its-me-ivan/Capstone/FEA/11 Guage 1010 Steel Stress 100lbf.JPG

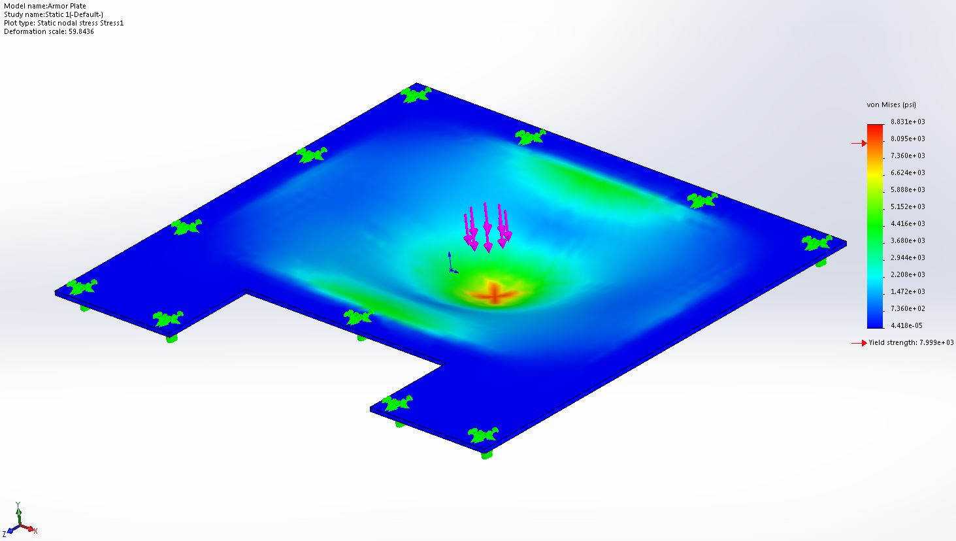
FEA/11 Guage 1010 Steel Stress 100lbf.JPG
