its-me-ivan/Capstone/FEA/3-16 Aluminum Stress 100lbf.JPG

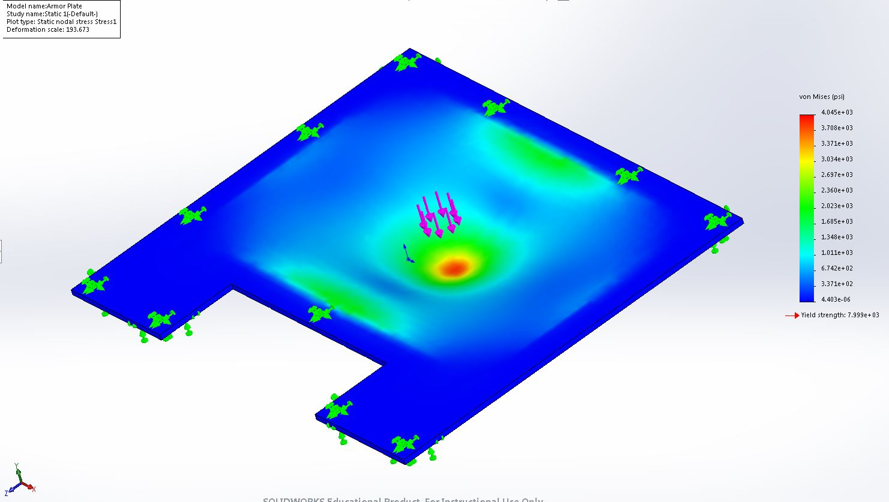
FEA/3-16 Aluminum Stress 100lbf.JPG
