its-me-ivan/Capstone/Written Report/Background.docx

# Background

From studying Battlebot competitions, a few archetypes become evident among the serious competitors. One such archetype is to have a bot with a fast spinning blade to try and shred the opponent. Another common design uses a mechanism such as a claw to try and grab the other robot and move them into obstacles. Some successful bots utilize a studded roller on the front of the bot that spins at high speed and charges the opponent to try and flip them. “Spatula” style flipping bots are also common, which slip an arm or mechanism under the opposing bot and use that to flip them. Robots that hammer the opponent with a large weapon arm often do well and can reap a lot of damage, the downfall (especially for this class of bots) is weight restriction. A heavy hammer as well as counterweight is necessary for such damage. These archetypes provide not only a starting point for deciding what our robot will do, but a point of reference for what our robot may have to face.

Consideration of different potential opponents lead to consideration of different materials to use in response to such opponents. These preliminary considerations include that for electronic housing, armor, chassis, and wheels. (Factors of each include Strength/durability/toughness vs weight/cost/machinability/allowance for heat flow away from electronic components). For example, using aluminum 6061 for parts of chassis which does not have to withstand much abuse is one initial idea. 6061 is lightweight and easily machined. It is also easily welded which will prove useful, the tradeoff is that (compared to steel or even al 7075) it is lower in strength and hardness. 7075 however is much less easily machined/ welded. Meaning that it would best used as an outer layer of armor which does not have to be welded to or interact with other components other than the chassis. Simple geometry could be used to limit the manufacturing of 7075 needed, alternatively, the utilization of a thin outer layer of UHMW polyethylene on the outside of the 6061 armor. UHMWPE has an extremely high yield point, and for a 25 pound bot, is nearly unbreakable yet is able to deform enough to dampen a heavy impact without fracture.

As for mobilization, after watching many battle bot competitions, it seems that the most common steering system is a dead axle “tank” type control system. Meaning that the left and right drivers are independent and used to steer left or right based on which motor is causing the most displacement. The turn radius and response time seems to be dictated by the distance separating inline wheels as well as distance between parallel pairs, this seems to be mostly determined through trial and error. Still under the branch of mobilization, several sizes and materials for wheels are on the market. After reading blogs published by other bot builders and by going to websites such as BaneBots.com (which manufactures quality yet affordable bot components including motors wheels gearboxes etc), it seems that Colson wheels are a good option, they are made of a durable lightweight propylene core with a thermoplastic rubber tread which will provide excellent traction on the concrete/asphalt arena. Battlebots also manufactures affordable motors available in a large variety of sizes, voltages, speeds, torques, and prices. The selected motor for this bot will also depend on the input/output voltage of the selected Arduino.

For the electronic control systems on the project, Arduino based microcontrollers are an attractive option. Many of these microcontrollers are inexpensive and Arduino is widely used by hobbyists, so resources are abundant. Arduinos also come in many shapes and sizes with different features, inputs and outputs. Keeping the electronics cheap and modular will be an important aspect to pay attention too.

Another option for the control system would be to take apart a second-hand remote-controlled vehicle and use its receiver and components. A remote-controlled plane might be a good option as they have more control surfaces and servos than a car.
