its-me-ivan/Capstone/Memos/MEMO_Week11.docx

To: James Black

Group leader: Ivan Albert for Group: Battlebots 3

CC: D2L Dropbox

Date: 11/28/18

Re: ETME/EMEC (489 or 499) Weekly Progress

# Progress

Tasks Completed:

- Finalization of solid model
- FEA of frame pieces and weapon to see their reactions under stress
- Drawing Package

Work in Progress:

- Prepare CDR materials
- Manufacturing plan
- Budget calcualtion

Upcoming Tasks and personnel assignments:

- CDR
- Compile final report

Issues and Concerns:

- Time constraints on final report
