its-me-ivan/Capstone/Memos/MEMO_Week10.docx

To: James Black

Group leader: Cole Trugman for Group: Battlebots 3

CC: D2L Dropbox

Date: 11/23/18

Re: ETME/EMEC (489 or 499) Weekly Progress

# Progress

Tasks Completed:

- Some reworking of design and solid model, using two motors instead of 4 to drive and adding a bigger weapon.
- Found electrical components for final design
- Calculations for minimum axle diameters

Work in Progress:

- Complete SolidWorks model
- Complete manufacturing plan

Upcoming Tasks and personnel assignments:

- Begin drawing package
- Prepare CDR presentation
- Make Budget plan

Issues and Concerns:

- Minimal experience with electrical systems
- Short timeframe to design solid model
- Mounting roller such that it can be removeable
- Absence of a group member
