its-me-ivan/Capstone/Memos/MEMO_Week8.docx

To: James Black

Group leader: Ivan Albert for Group: Battlebots 3

CC: D2L Dropbox

Date: 11/07/18

Re: ETME/EMEC (489 or 499) Weekly Progress

# Progress

Tasks Completed:

- Microcontroller for the Bot was chosen
- Brainstormed some ideas about the Bot model
- Came up with the basic sketch model of the Bot

Work in Progress:

- Flesh out SolidWorks model
- Update Project Management schedule

Upcoming Tasks and personnel assignments:

- Do some calculations regarding design allowable dimensions ( roller diameter, axle diameter)
- Research about motor power, and heat dissipated
- Collectively move forward with the SolidWorks model
- Make manufacturing plan
- Make Budget plan

Issues and Concerns:

- Minimal experience with electrical systems
- Short timeframe to design solid model
