its-me-ivan/Capstone/Written Report/Design Alternatives Tables.xlsx

Drive System | Maneuverability (Weight 2) | Ease of Implementation (Weight 1) | Durability (Weight 2) | Cost (Weight 1) | Total Points | Design | Drive System | Electrical System | Weapon | Armor | Total Points
Live Axel | -1 | 0 | 1 | 2 | 2 | Design 1 | Dead Axel: Wheels | Microcontroller: Bluetooth | Roller | Aluminum
Dead Axel | X | X | X | X | X |  | 9 | 8 | 9 | 4 | 30
Wheels | 1 | 2 | 2 | 1 | 9 | Design 2 | Omni Wheels | Microcontroller: Radio | Hammer | UHMWPE
Tank Treads | 1 | 1 | 0 | 0 | 3 |  | 1 | 6 | 7 | 2 | 16
Omni Wheels | 2 | -1 | -1 | 0 | 1 | Design 3 | Dead Axel: Wheels | Microcontroller: Bluetooth | Hydraulic Wedge | 1018 Steel
 |  |  |  |  |  |  | 9 | 8 | 1 | 2 | 20
Electronic Control System | Ease of Implementation (Weight 1) | Reliability of Control (Weight 1) | Versatility (Weight 2) | Cost (Weight 1) | Total Points
Off the Shelf RC Parts | 2 | 2 | -2 | 1 | 1
Microcontroller | X | X | X | X | X
Bluetooth | 1 | 1 | 2 | 2 | 8
Wi-Fi | 0 | 1 | 1 | 1 | 4
Radio | -1 | 2 | 2 | 1 | 6
Weapon System | Damage (Weight 2) | Ease of Implementation (Weight 1) | Ease of Use (Weight 2) | Cost (Weight 1) | Total Points
Hammer | 2 | 1 | 1 | 0 | 7
Roller | 2 | 1 | 2 | 0 | 9
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
