its-me-ivan/Capstone/PDR/Design Alternatives Tables PDR.xlsx

Drive System | Maneuverability | Ease of Implementation | Durability | Cost | Total Points | Design | Drive System | Electrical System | Weapon | Armor | Total Points
Live Axel | -1 | 0 | 1 | 2 | 2 | Design 1 | Dead Axle: Wheels | Micro: Bluetooth | Roller | Aluminum
Dead Axel | X | X | X | X | X |  | 6 | 5 | 5 | 3 | 19
Wheels | 1 | 2 | 2 | 1 | 6 | Design 2 | Omni Wheels | Micro: Radio | Hammer | UHMWPE
Tank Treads | 1 | 1 | 0 | 0 | 2 |  | 0 | 4 | 4 | 1 | 9
Omni Wheels | 2 | -1 | -1 | 0 | 0 | Design 3 | Dead Axle: Wheels | Micro: Bluetooth | Hydraulic Wedge | 1018 Steel
 |  |  |  |  |  |  | 6 | 5 | 0 | 2 | 13
Electronic Control System | Ease of Implementation | Reliability of Control | Versatility | Cost | Total Points
Off the Shelf RC Parts | 2 | 2 | -2 | 1 | 3
Microcontroller | X | X | X | X | X
Bluetooth | 1 | 1 | 2 | 1 | 5
Wi-Fi | 0 | 1 | 1 | 1 | 3
Radio | -1 | 2 | 2 | 1 | 4
Weapon System | Damage | Ease of Implementation | Ease of Use | Cost | Total Points
Hammer | 2 | 1 | 1 | 0 | 4
Roller | 2 | 1 | 2 | 0 | 5
Hydraulic Wedge | 0 | 0 | 1 | -1 | 0
"Hermit Crab" | 1 | 1 | -1 | 1 | 2
Spatula | 1 | 0 | 0 | -1 | 0
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
