its-me-ivan/Capstone/Memos/MEMO_Week5.docx

To: James Black

Group leader: Nishagar Raventhiran Group: Battlebots 3

CC: D2L Dropbox

Date: 10/10/18

Re: ETME/EMEC (489 or 499) Weekly Progress

# Progress

Tasks Completed:

- Chapter 4: Design Specifications
- Chapter 5: Design Alternatives

Work in Progress:

- Ideation
- Calculations to size motors/batteries for design specs

Upcoming Tasks and personnel assignments:

- Update master project management plan

Issues and Concerns:

- Minimal experience with electrical systems
