its-me-ivan/Capstone/Written Report/Problem Statement-Signed.pdf

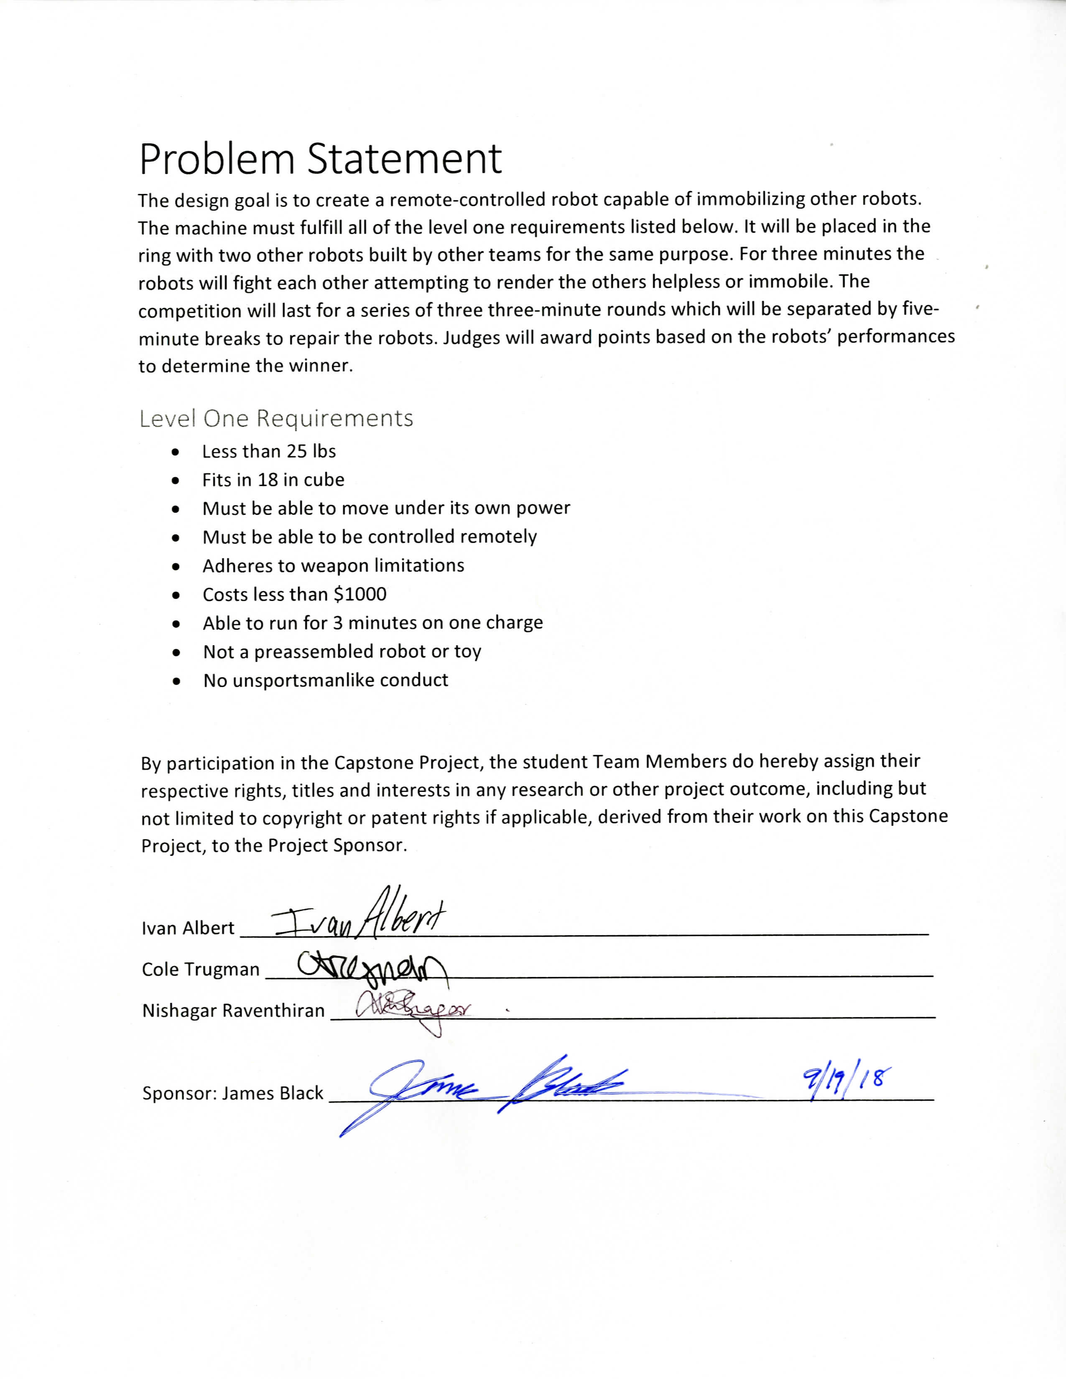
[picture p45: page 1]
