its-me-ivan/Capstone/Solidworks/Drawings/Armor Plate1.JPG

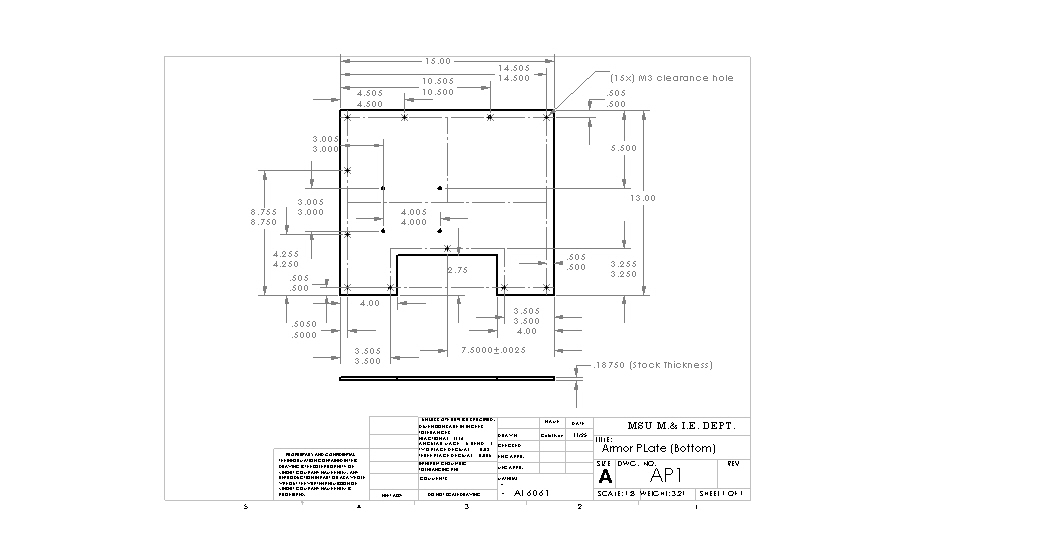
Solidworks/Drawings/Armor Plate1.JPG
