its-me-ivan/Capstone/Order Budget.xlsx

Item | Distributer | Price (Indiv) | Quantity | Price (Total)
Locally Purchased Parts
1"x2" Aluminum Rectangular Tube, 7ft | Pacific Steel & Recycling | $33.00 | 1 | $33.00 | X
1/2" Cold Rolled Steel Rod, 3ft | Pacific Steel & Recycling | $7.00 | 1 | $7.00 | X
Aluminum Flat ( Thickness)
Steel (Roller Hub)
Aluminum fo Gear box (
5/8" Hot Rolled Steel Rod, 3ft | Pacific Steel & Recycling | $6.00 | 1 | $6.00 | X
10 Guage Steel Sheet, 2"x4" | Pacific Steel & Recycling | $100.00 | 1 | $100.00
 |  | Vendor Total |  | $146.00
Ordered Parts
13A, 5-30V Single DC Motor Controller | RobotShop | $11.55 | 3 | $34.65
 |  | Shipping Cost |  | $9.00
 |  | Vendor Total |  | $43.65
6mm Bore 48 Pitch Shaft Mount Pinion Gears | ServoCity | $12.99 | 2 | $25.98
118 RPM HD Premium Planetary Gear Motor | ServoCity | $39.99 | 2 | $79.98
1621 RPM HD Premium Planetary Gear Motor | ServoCity | $39.99 | 2 | $79.98
 |  | Shipping Cost |  | $6.99
 |  | Vendor Total |  | $192.93
Tenergy NiMH 12V 4200mAh Rechargeable Battery Pack | All-Battery | $69.99 | 2 | $139.98 | X
 |  | Shipping Cost |  | $0.00
 |  | Vendor Total |  | $139.98
Colson Wheel 5in x 1-1/4in | BaneBots | $3.03 | 6 | $18.18
Colson Series 2 Hub, Press Fit, 1/2 Plain Bore, Clamp Hub | BaneBots | $4.87 | 4 | $19.48
 |  | Shipping Cost |  | $14.15
 |  | Vendor Total |  | $51.81
Raspberry Pi Zero W | Adafruit | $10.00 | 1 | $10.00 | X
 |  | Shipping Cost |  | $4.15
 |  | Vendor Total |  | $14.15
SanDisk Ultra 32GB | Amazon | $8.45 | 1 | $8.45 | X
BW® RC Servo BEC UBEC 3A 5V for Helicopter Airplane Receiver Servo Power Supply | Amazon | $7.99 | 1 | $7.99 | X
 |  | Shipping Cost |  | $0.00
 |  | Vendor Total |  | $16.44
1375k450 - MXL Series Timing Belt Pulley | McMaster-Carr | $11.73 | 1 | $11.73
1375k560 - MXL Series Timing Belt Pulley | McMaster-Carr | $15.89 | 4 | $63.56
1254N21 - MXL Series Lightweight Timing Belt Pulley | McMaster-Carr | $7.46 | 1 | $7.46
1434k600 - Mounted Roller Bearing with Two-Bolt Flange | McMaster-Carr | $17.67 | 4 | $70.68
6832k44 - Metal Gear - 20 Degree Pressure Angle | McMaster-Carr | $21.55 | 2 | $43.10
6383k213 - Ball Bearing | McMaster-Carr | $3.97 | 2 | $7.94
92871A013 - 18-8 Stainless Steel Unthreaded Spacer | McMaster-Carr | $1.72 | 12 | $20.64
7887K88 - MXL Series Timing Belt | McMaster-Carr | $5.66 | 2 | $11.32
7887K82 - MXL Series Timing Belt | McMaster-Carr | $2.85 | 1 | $2.85 | 4.24 center
92095A182 - Button Head Hex Drive Screw - 100 pack | McMaster-Carr | $8.38 | 1 | $8.38
92095A203 - Button Head Hex Drive Screw - 25 pack | McMaster-Carr | $4.28 | 1 | $4.28
99437A135 - Zinc-Plated Steel Press-Fit Nut for Sheet Metal - 10 pack | McMaster-Carr | $6.13 | 2 | $12.26
 |  | Shipping Cost |  | Unknown
 |  | Vendor Total |  | $264.20
 |  | Total Cost |  | $869.16
 |  | Total Budget |  | $1000.00
 |  | Remaining Budget |  | $130.84
Bolts /screws
Armor (Screw) | 18 x >.5" | 4>.625"
Gearboxes (Bolt/Nut) | 8 x 1.5"
Motors | 12 x
Electronic Mount
Bearings (Bolt/Nut) | 8 x .5"
Roller mount | 2 x >.25"
