its-me-ivan/Capstone/Written Report/Part List.xlsx

Sheet: Purchased Parts
Part Number | Description | Manufacturer/Vendor | Vendor Part Number | Quantity
P1 | MXL series timing belt pulley, 24 teeth, 1/4 in shaft diameter | McMaster-Carr | 1375k450 | 2
P2 | MXL series timing belt pulley, 42 teeth, 1/4 in shaft diameter | McMaster-Carr | 1375k560 | 4
P3 | Mounted roller bearing with two-bolt flange for 1/2" shaft diamteter | McMaster-Carr | 1434k600 | 4
P4 | Metal gear, 48 pitch, 36 teeth, round bore with set screw for 1/4" shaft diameter | McMaster-Carr | 6832k44 | 2
P5 | Flanged ball bearing for 1/4" shaft | McMaster-Carr | 6383k213 | 2
P6 | 118 RPM HD Premium Planetary Gear Motor | ServoCity | 118 RPM HD Premium Planetary Gear Motor | 2
P7 | 1621 RPM HD Premium Planetary Gear Motor | ServoCity | 1621 RPM HD Premium Planetary Gear Motor | 1
P8 | Tenergy NiMH 12V 4200mAh Rechargeable Battery Pack | All-Battery | 11600 | 2
P9 | RC Servo BEC UBEC 3A 5V for Helicopter Airplane Receiver Servo Power Supply | BW/Amazon | RC Servo BEC UBEC 3A 5V for Helicopter Airplane Receiver Servo Power Supply | 1
P10 | 13A, 5-30V Single DC Motor Controller | Cytron/RobotShop | RB-Cyt-132 | 3
P11 | Raspberry Pi Zero W | Raspberry Pi Foundation/Adafruit | 3400 | 2
P12 | 18-8 SS 10mm long M3 spacer | McMaster-Carr | 92871A013 | 12
P13
P14
P15
P16
P17
P18
P19
P20
P21
P22
P23
P24
P25

Sheet: Raw Materials
Material Number | Description | Manufacturer/Vendor | Quantity
R1 | 10 ft 1"x2"x1/8" 6063-T52 Aluminum Rectangular Tube | Midwest Steel and Aluminum | 1
R2 | 3/16" 6061 Aluminum Plate 2'x3' | The Metal Store | 1
R3 | 4"x5"x0.25 foam | scrap | 1
R4 | PLA Fillament | MSU Makerspace | 4 parts
R5 | 2"x2"x1' 6061 Aluminum Square Bar | Metals Depot | 1
R6 | 1/2" 1018 Cold Finish Steel Round 4ft length | Metals Depot | 1
R7 | 5/8" 1018 Cold Finish Steel Round 2ft length | Metals Depot | 1
R8 | 3/8"x4"x2' A-36 Steel Flat | Metals Depot | 1
R9
R10
R11
R12
R13
