its-me-ivan/Capstone/Budget Plan (version 1).xlsx

Parts | Quantity | price of each | Total cost | Total budget
165 RPM HD Premium Planetary Gear Motor | 2 | $39.99 | $79.98 | $822.58
Cytron 13A, 5-30V Single DC Motor Controller | 4 | $13.82 | $55.28
Raspberry Pi Zero W | 2 | $10.00 | $20.00
Tenergy NiMH 12V 4200mAh Rechargeable Battery Pack | 2 | $69.99 | $139.98
1,621 RPM HD Premium Planetary Gear Motor | 1 | $39.99 | $39.99
RC Servo BEC UBEC 3A 5V ( Receiver servo Power supply) | 1 | $7.99 | $7.99
6063-T52 Aluminum Rectangle Tube(2X1X1/8 Wall) | 1 | $32.15 | $32.15
3/16 inch. thick 6061 Aluminum Plate (2 ftX3 ft) | 1 | $109.47 | $109.47
5/8" Hot Rolled A-36 Steel Round | 1 | $5.14 | $5.14
1/2" Hot Rolled A-36 Steel Round | 1 | $6.60 | $6.60
Bearing | 4 | $11.00 | $44.00
Roller Bearing | 2 | $10 | $20.00
Pulley | 4 | $16.00 | $64.00
Driving Belt | 2 | $6.00 | $12.00
Gears | 2 | $22.00 | $44.00
Gears | 2 | $13.00 | $26.00
5" wheels/hubs | 6 | $16.00 | $96.00
Screws | 1 | $20.00 | $20.00
