its-me-ivan/Capstone/Budget Plan.xlsx

Parts | Quantity | price of each | Total cost | Total budget
165 RPM HD Premium Planetary Gear Motor | 2 | $39.99 | $79.98 | $382.60
Cytron 13A, 5-30V Single DC Motor Controller | 3 | $13.82 | $41.46
Raspberry Pi Zero W | 1 | $10.00 | $10.00
Tenergy NiMH 12V 4200mAh Rechargeable Battery Pack | 2 | $69.99 | $139.98
1,621 RPM HD Premium Planetary Gear Motor | 1 | $39.99 | $39.99
6063-T52 Aluminum Rectangle Tube(2X1X1) | 1 | $3.49 | $3.49
6061-T6511 Aluminum Flat(31/16 X 6X 18) | 1 | $61.70 | $61.70
Hot Rolled A-36 Steel Round 30 in | 1 | $6.00 | $6.00
Bearings
