its-me-ivan/Capstone/Solidworks/Subassemblies/Robot 2.SLDASM

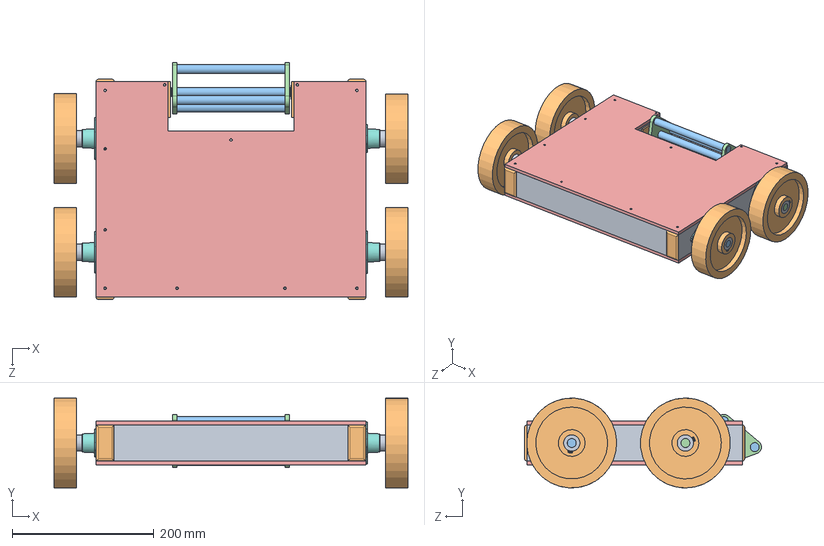
[picture p47: CAD file, 2019-02-06]
Solidworks/Subassemblies/Robot 2.SLDASM
500.0 x 127.0 x 334.7 mm
Box Frame x 8
Tube Cap x 4
Roller 2 Bar x 4
Roller Bracket x 2
Armor Plate x 2
Gearbox x 2
Motor x 3
Pinion Gear x 2
Motor Mount
Electronic Mounting Plate Foam
Electronic Mounting Plate
Motor Control Board x 3
Raspberry Pi
92871A013_SS UNTHRD SPACER x 8
Drivin GEAR--20 DEG PRESSURE ANGLE x 2
1434K600_LIGHT DTY TWO-BOLT FLANGE-MOUNTED ROLLER BRNG x 4
Wheel Hub x 4
Wheel x 4
Axle Cole x 2
Axle2 Cole x 2
Battery Pack
1375K560_MXL SERIES TIMING BELT PULLEY(.5) x 4
Roller Motor MXL SERIES LIGHTWEIGHT TIMING BELT PULLEY
(Roller) 6383K213_BALL BEARING x 2
(Roller)1375K450_MXL SERIES TIMING BELT PULLEY
Roller Attachment 2 x 2
