its-me-ivan/Capstone/Solidworks/Subassemblies/Frame 2.SLDASM

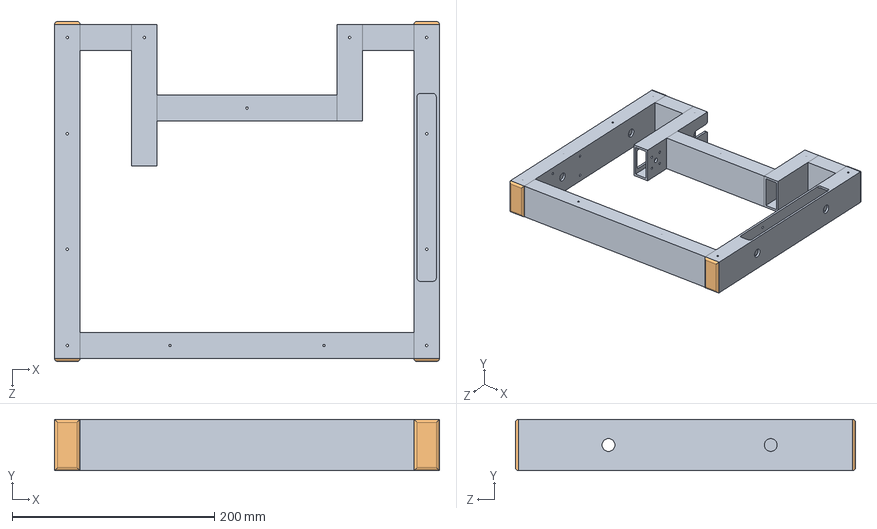
[picture p48: CAD file, 2019-02-05]
Solidworks/Subassemblies/Frame 2.SLDASM
381.0 x 50.8 x 336.5 mm
Box Frame x 8
Tube Cap x 4
