its-me-ivan/Capstone/Solidworks/Subassemblies/Gearbox.SLDASM

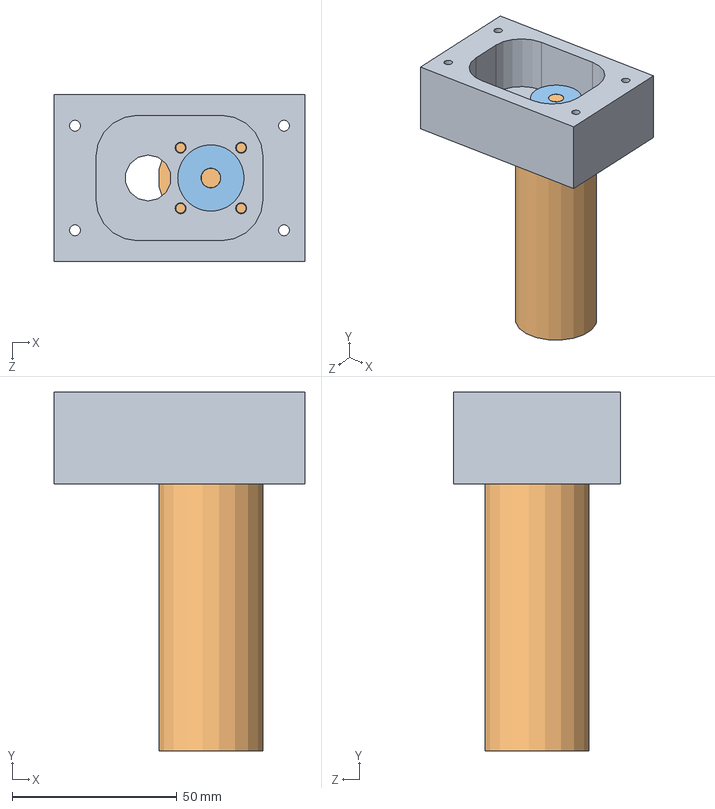
[picture p49: CAD file, 2019-02-05]
Solidworks/Subassemblies/Gearbox.SLDASM
76.2 x 109.0 x 50.8 mm
Gearbox
Motor
Pinion Gear
