its-me-ivan/Capstone/Solidworks/Subassemblies/Roller 2.SLDASM

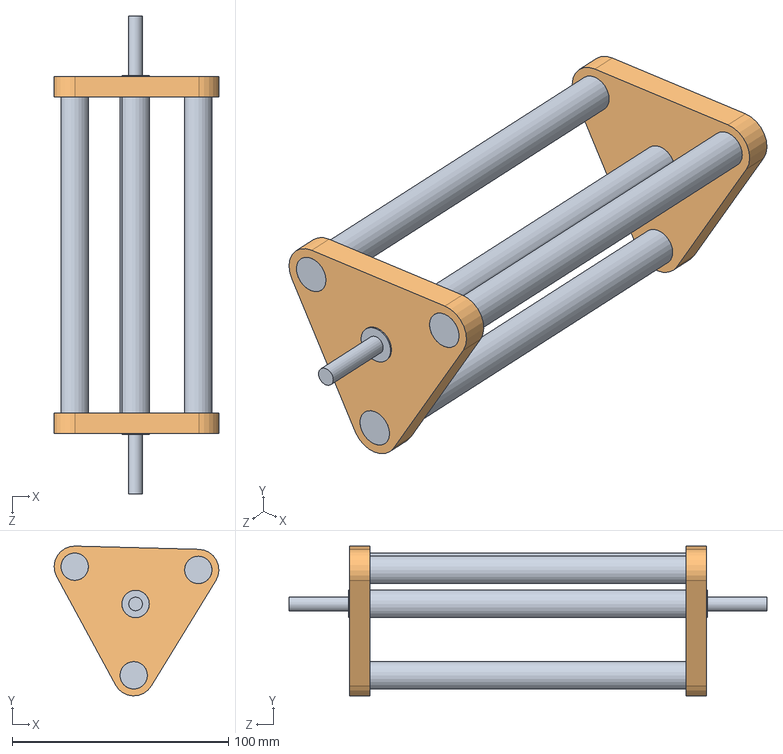
[picture p50: CAD file, 2019-02-05]
Solidworks/Subassemblies/Roller 2.SLDASM
76.2 x 69.3 x 221.0 mm
Roller 2 Bar x 4
Roller Bracket x 2
