its-me-ivan/Capstone/Solidworks/Subassemblies/Electrical Mounting.SLDASM

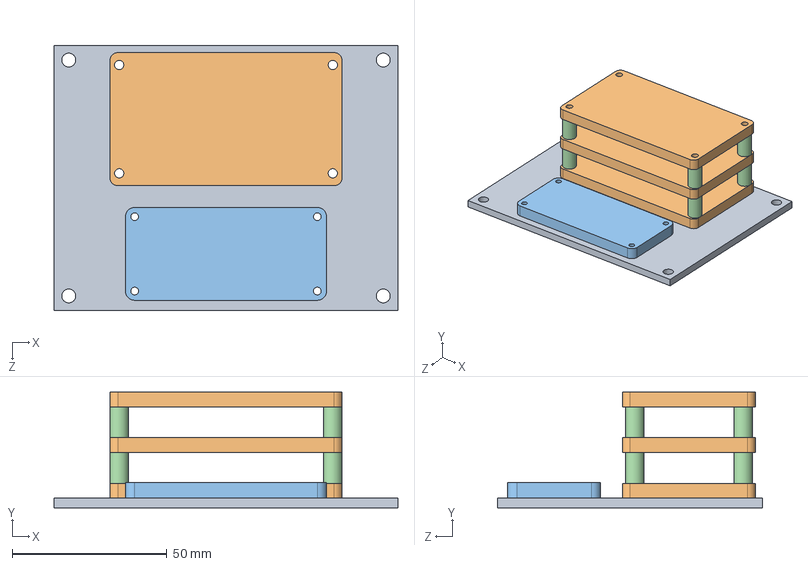
[picture p51: CAD file, 2018-11-29]
Solidworks/Subassemblies/Electrical Mounting.SLDASM
111.1 x 37.5 x 85.7 mm
Electronic Mounting Plate
Motor Control Board x 3
Raspberry Pi
92871A013_SS UNTHRD SPACER x 8
