its-me-ivan/Capstone/Solidworks/Subassemblies/Roller.SLDASM

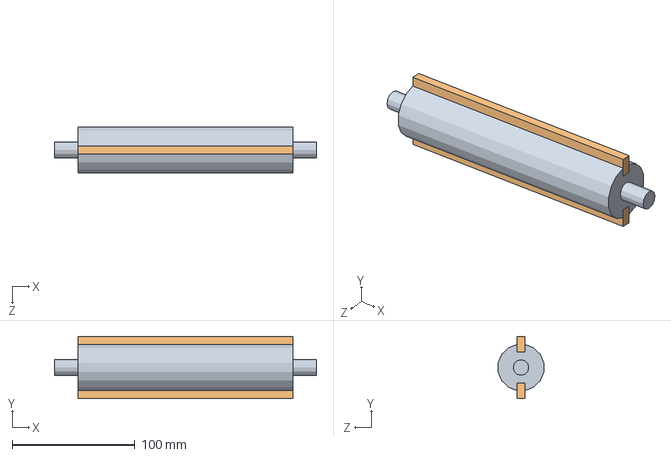
[picture p52: CAD file, 2018-11-13]
Solidworks/Subassemblies/Roller.SLDASM
213.4 x 50.8 x 37.3 mm
Roller
Roller Tooth x 2
