its-me-ivan/Capstone/Solidworks/Subassemblies/Frame.SLDASM

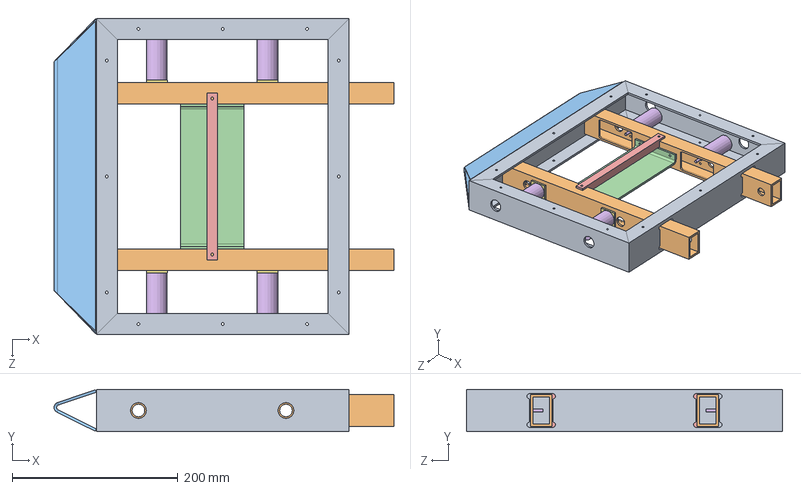
[picture p53: CAD file, 2018-11-13]
Solidworks/Subassemblies/Frame.SLDASM
409.7 x 50.8 x 381.0 mm
Frame C-Channel x 4
Roller Arm x 2
Rear Bumper
Electronics Tray
Cross Brace x 2
Motor x 4
Motor Mount x 4
