its-me-ivan/Capstone/Solidworks/Subassemblies/Robot.SLDASM

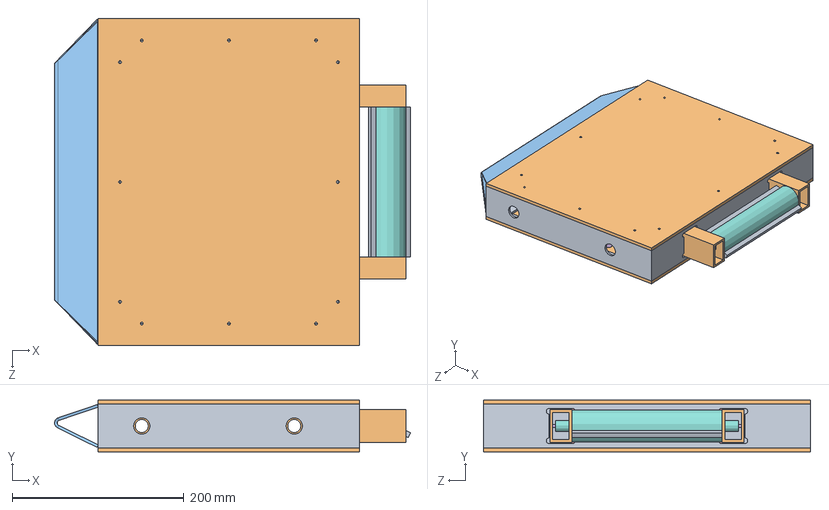
[picture p54: CAD file, 2018-11-13]
Solidworks/Subassemblies/Robot.SLDASM
415.0 x 60.3 x 381.0 mm
Frame C-Channel x 4
Roller Arm x 2
Rear Bumper
Electronics Tray
Cross Brace x 2
Motor x 5
Motor Mount x 5
Roller
Roller Tooth x 2
Armor Plate x 2
Raspberry Pi
