its-me-ivan/Capstone/Solidworks/Electronics/Electronic Mounting Plate.SLDPRT

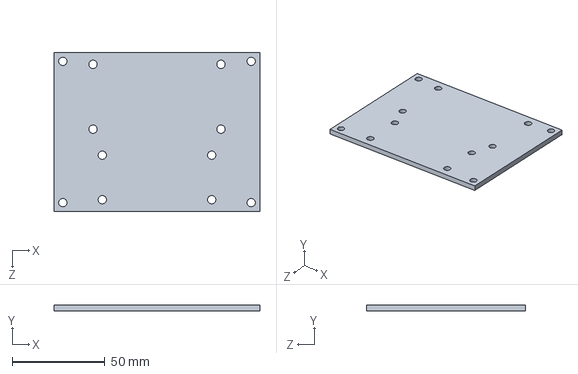
[picture p55: CAD file, 2018-11-29]
Solidworks/Electronics/Electronic Mounting Plate.SLDPRT
111.1 x 3.17 x 85.7 mm
