its-me-ivan/Capstone/Solidworks/Hardware/Wheel Hub.SLDPRT

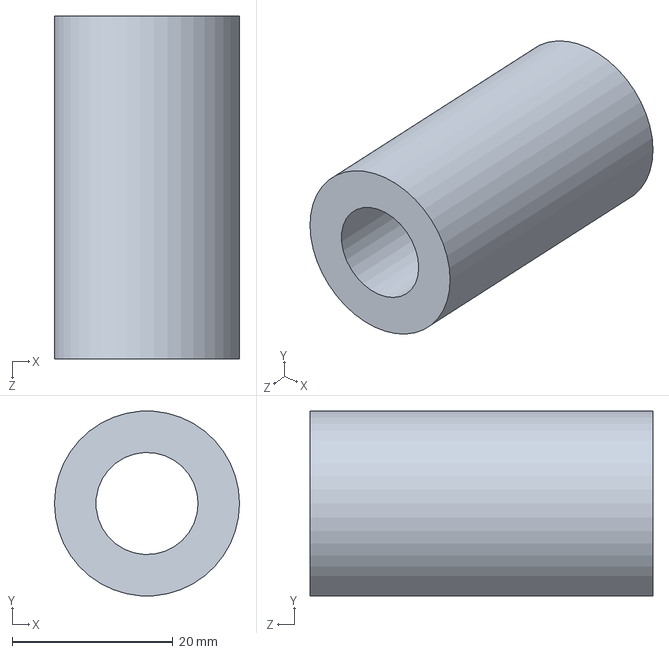
[picture p56: CAD file, 2019-02-06]
Solidworks/Hardware/Wheel Hub.SLDPRT
23.0 x 23.0 x 42.7 mm
