its-me-ivan/Capstone/Solidworks/Machined Parts/Armor Plate.SLDPRT

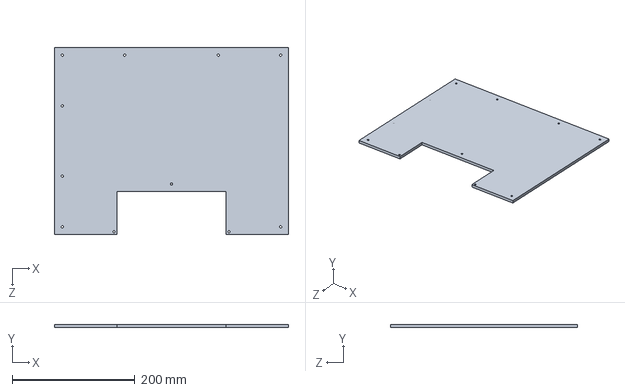
[picture p57: CAD file, 2019-02-06]
Solidworks/Machined Parts/Armor Plate.SLDPRT
381.0 x 5.59 x 304.8 mm
