its-me-ivan/Capstone/Solidworks/Electronics/Motor.SLDPRT

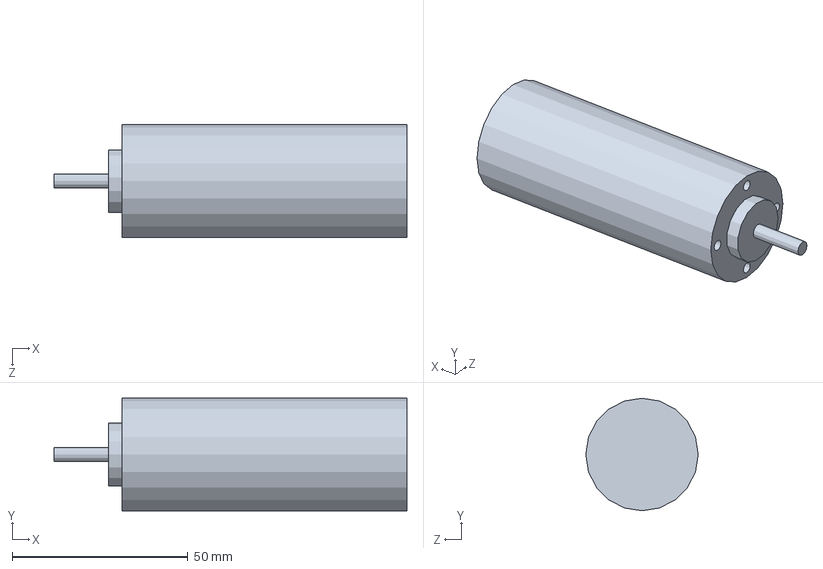
[picture p58: CAD file, 2018-11-26]
Solidworks/Electronics/Motor.SLDPRT
100.4 x 32.0 x 32.0 mm
