its-me-ivan/Capstone/Solidworks/Hardware/Wheel.SLDPRT

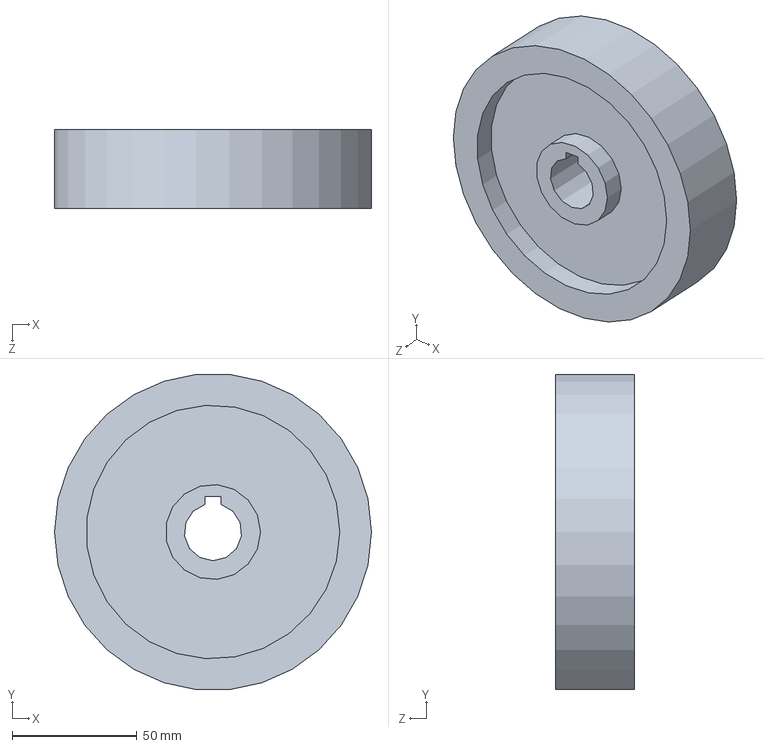
[picture p59: CAD file, 2019-02-06]
Solidworks/Hardware/Wheel.SLDPRT
127.0 x 126.3 x 31.8 mm
