its-me-ivan/Capstone/Solidworks/Machined Parts/Box Frame.SLDPRT

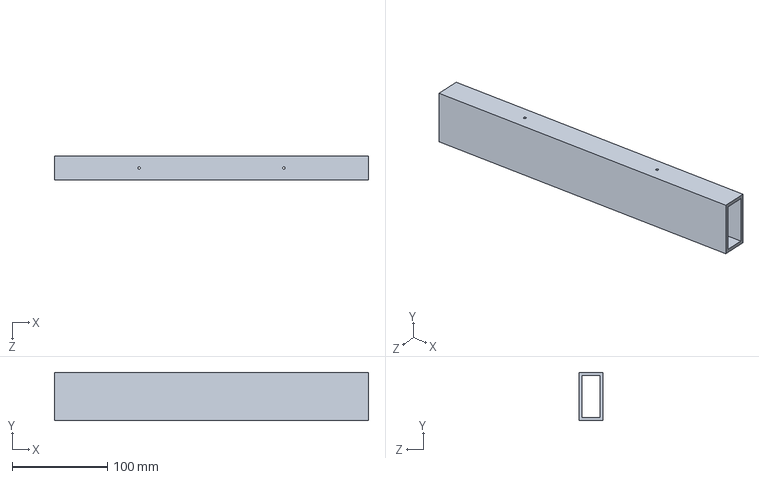
[picture p60: CAD file, 2019-02-05]
Solidworks/Machined Parts/Box Frame.SLDPRT
330.2 x 50.8 x 25.4 mm
