its-me-ivan/Capstone/Solidworks/Electronics/Raspberry Pi.SLDPRT

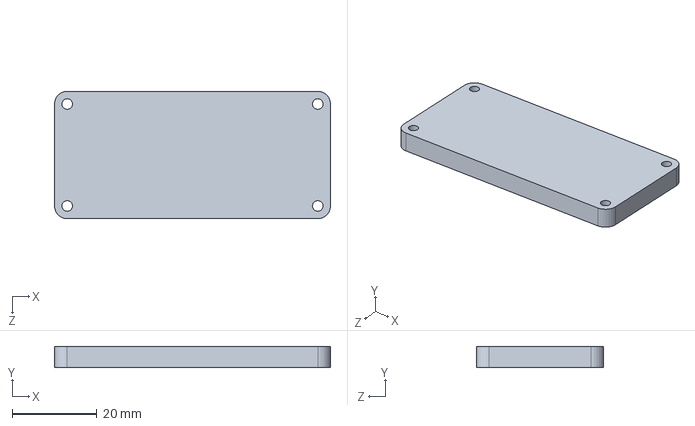
[picture p61: CAD file, 2018-11-24]
Solidworks/Electronics/Raspberry Pi.SLDPRT
65.0 x 5.00 x 30.0 mm
