its-me-ivan/Capstone/Solidworks/Hardware/Pinion Gear.SLDPRT

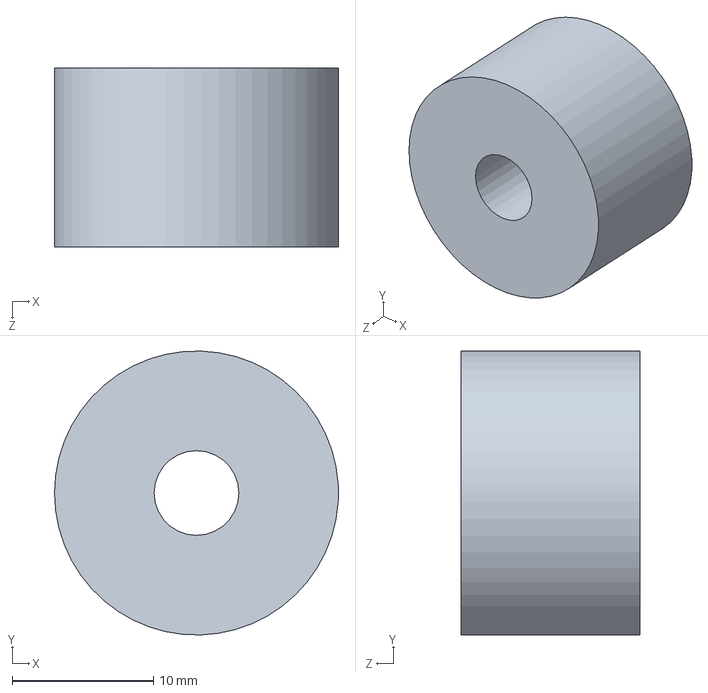
[picture p62: CAD file, 2018-11-24]
Solidworks/Hardware/Pinion Gear.SLDPRT
20.1 x 20.1 x 12.7 mm
