its-me-ivan/Capstone/Solidworks/Machined Parts/Gearbox.SLDPRT

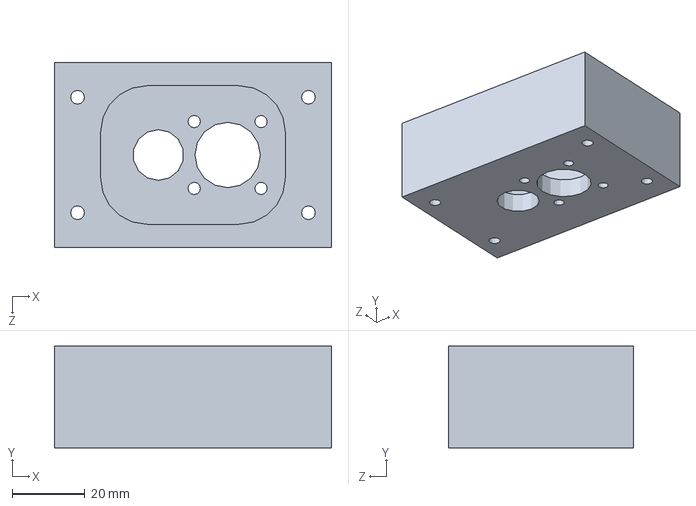
[picture p63: CAD file, 2019-02-05]
Solidworks/Machined Parts/Gearbox.SLDPRT
76.2 x 27.9 x 50.8 mm
