its-me-ivan/Capstone/Solidworks/Electronics/Motor Control Board.SLDPRT

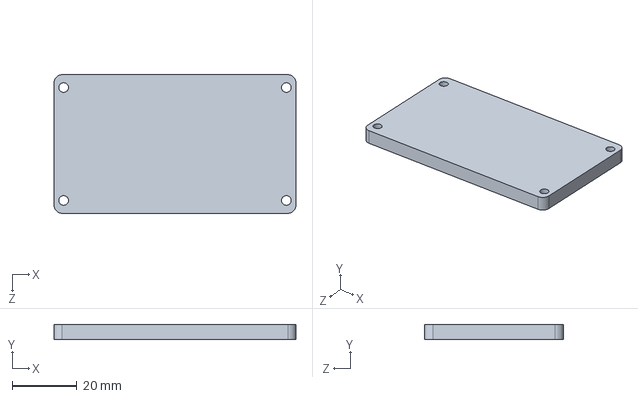
[picture p64: CAD file, 2018-11-24]
Solidworks/Electronics/Motor Control Board.SLDPRT
75.0 x 4.76 x 43.0 mm
