its-me-ivan/Capstone/Solidworks/Hardware/Axle.SLDPRT

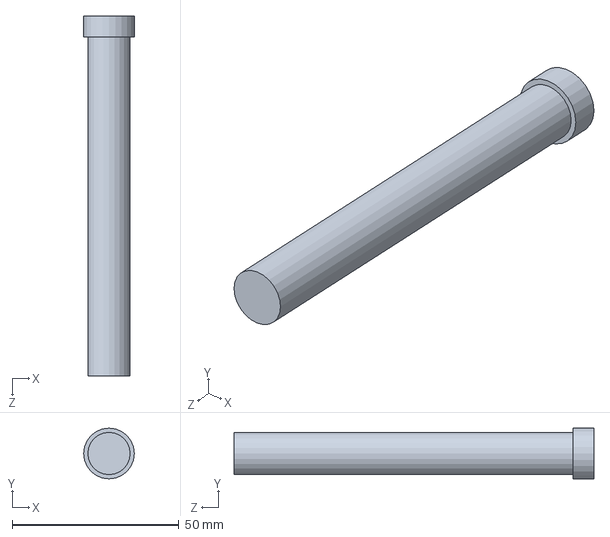
[picture p65: CAD file, 2018-11-22]
Solidworks/Hardware/Axle.SLDPRT
15.2 x 15.2 x 108.0 mm
