its-me-ivan/Capstone/Solidworks/Machined Parts/Roller Attachment 2.SLDPRT

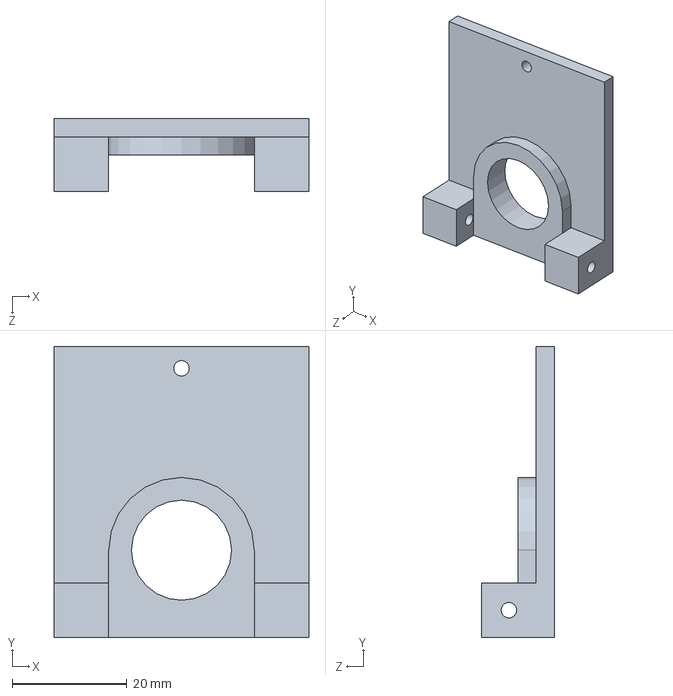
[picture p66: CAD file, 2019-02-05]
Solidworks/Machined Parts/Roller Attachment 2.SLDPRT
44.5 x 50.8 x 12.7 mm
