its-me-ivan/Capstone/Solidworks/Electronics/Electronic Mounting Plate Foam.SLDPRT

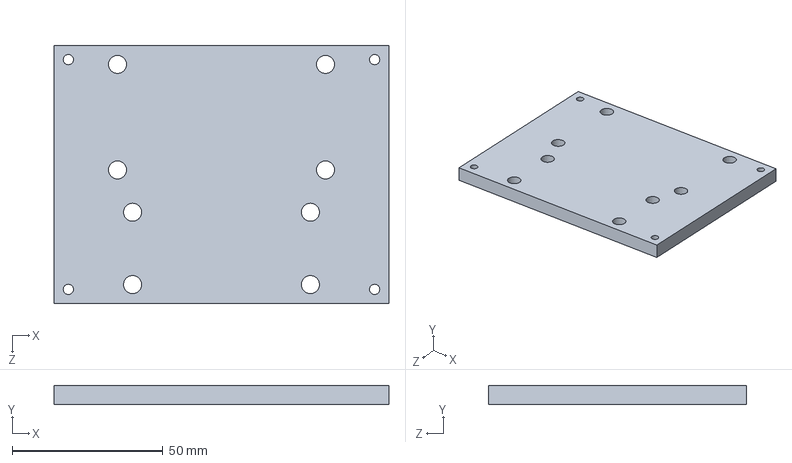
[picture p67: CAD file, 2018-11-24]
Solidworks/Electronics/Electronic Mounting Plate Foam.SLDPRT
111.1 x 6.35 x 85.7 mm
