its-me-ivan/Capstone/Solidworks/Machined Parts/Roller Bracket.SLDPRT

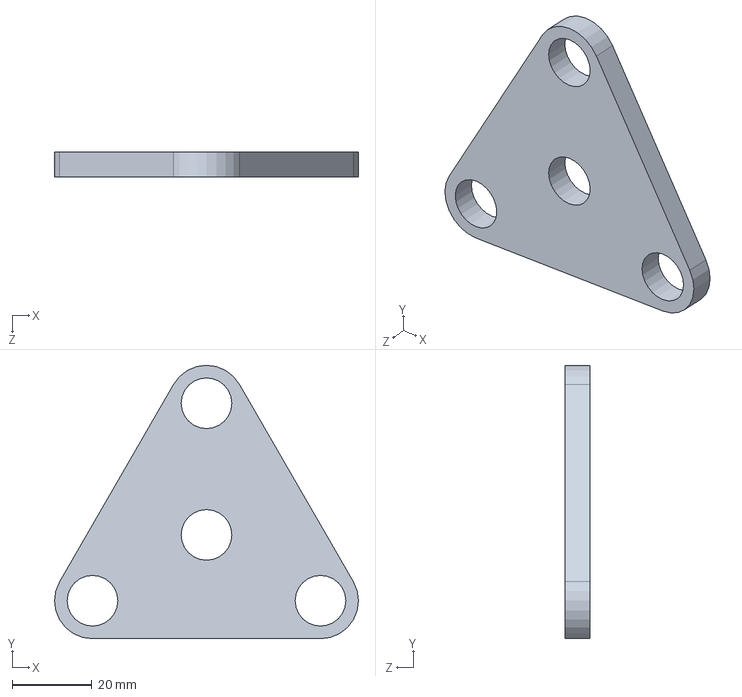
[picture p68: CAD file, 2019-02-05]
Solidworks/Machined Parts/Roller Bracket.SLDPRT
76.2 x 68.5 x 6.35 mm
