its-me-ivan/Capstone/Solidworks/Electronics/Battery Pack.SLDPRT

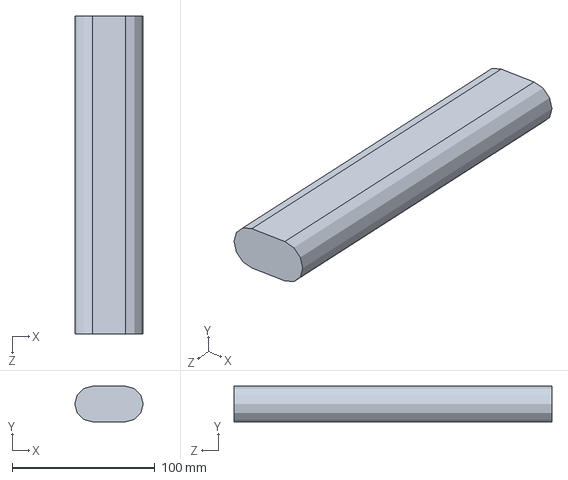
[picture p69: CAD file, 2018-11-24]
Solidworks/Electronics/Battery Pack.SLDPRT
48.0 x 25.0 x 223.0 mm
