its-me-ivan/Capstone/Solidworks/Machined Parts/Roller 2 Bar.SLDPRT

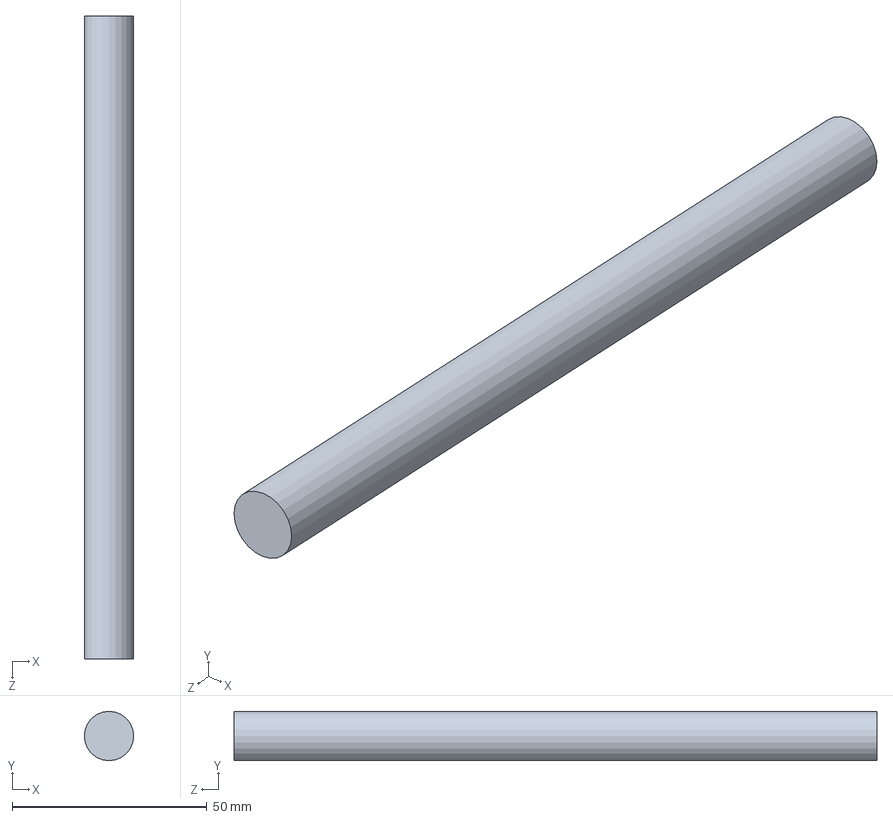
[picture p70: CAD file, 2019-01-17]
Solidworks/Machined Parts/Roller 2 Bar.SLDPRT
12.7 x 12.7 x 165.1 mm
