its-me-ivan/Capstone/Solidworks/Electronics/Motor2.SLDPRT

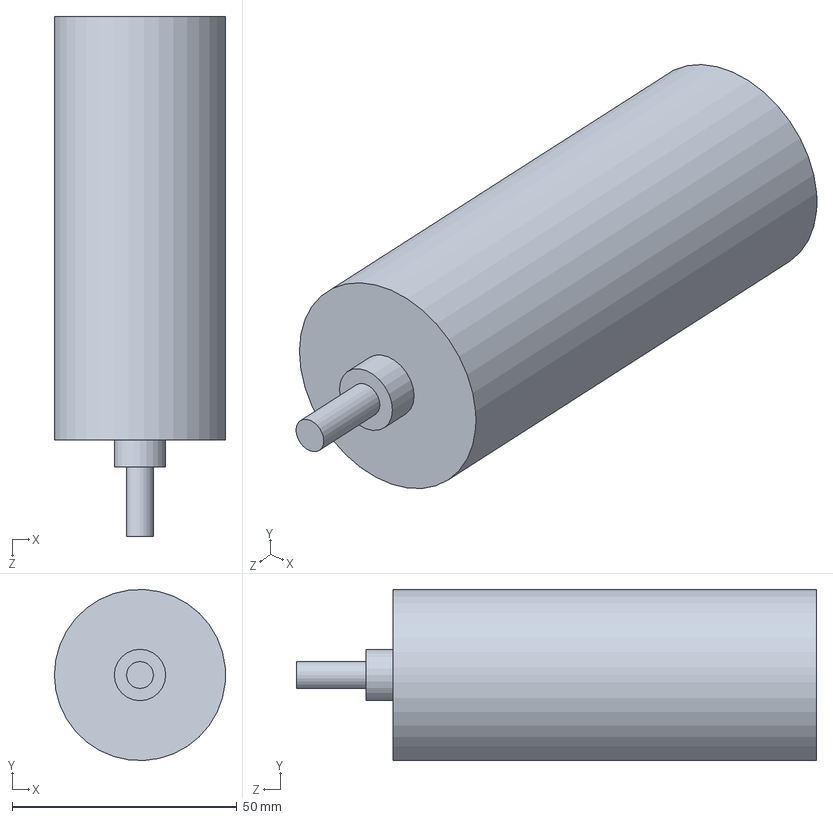
[picture p71: CAD file, 2018-11-23]
Solidworks/Electronics/Motor2.SLDPRT
38.1 x 38.1 x 115.7 mm
