its-me-ivan/Capstone/Solidworks/Machined Parts/Roller Brackets.SLDPRT

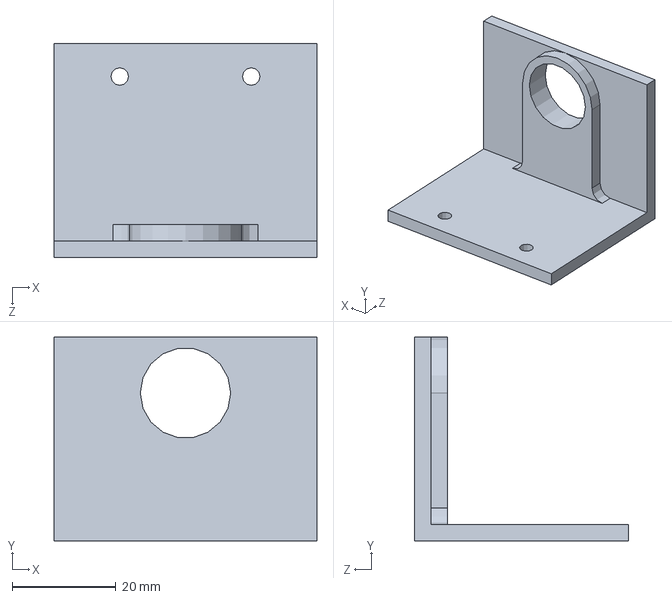
[picture p72: CAD file, 2019-01-17]
Solidworks/Machined Parts/Roller Brackets.SLDPRT
50.8 x 39.4 x 41.3 mm
