its-me-ivan/Capstone/Solidworks/Machined Parts/Tube Cap.SLDPRT

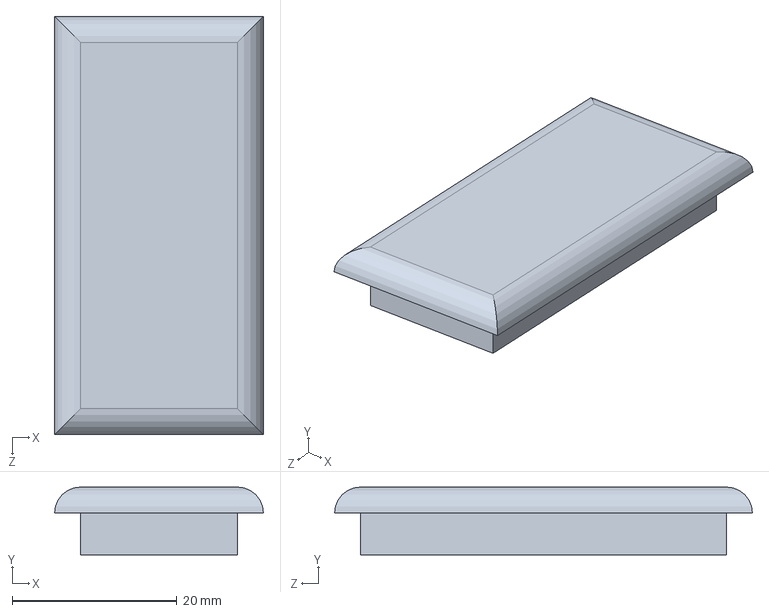
[picture p73: CAD file, 2018-12-06]
Solidworks/Machined Parts/Tube Cap.SLDPRT
25.4 x 8.26 x 50.8 mm
