its-me-ivan/Capstone/Solidworks/Machined Parts/Axle2 Cole.SLDPRT

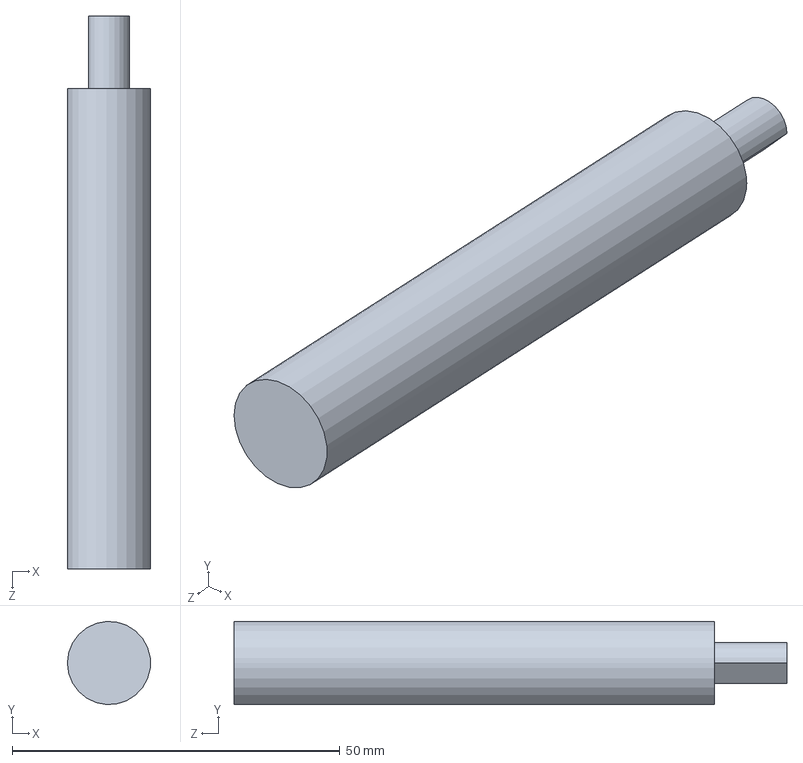
[picture p74: CAD file, 2018-11-27]
Solidworks/Machined Parts/Axle2 Cole.SLDPRT
12.7 x 12.7 x 84.4 mm
