its-me-ivan/Capstone/Solidworks/Machined Parts/Axle Cole.SLDPRT

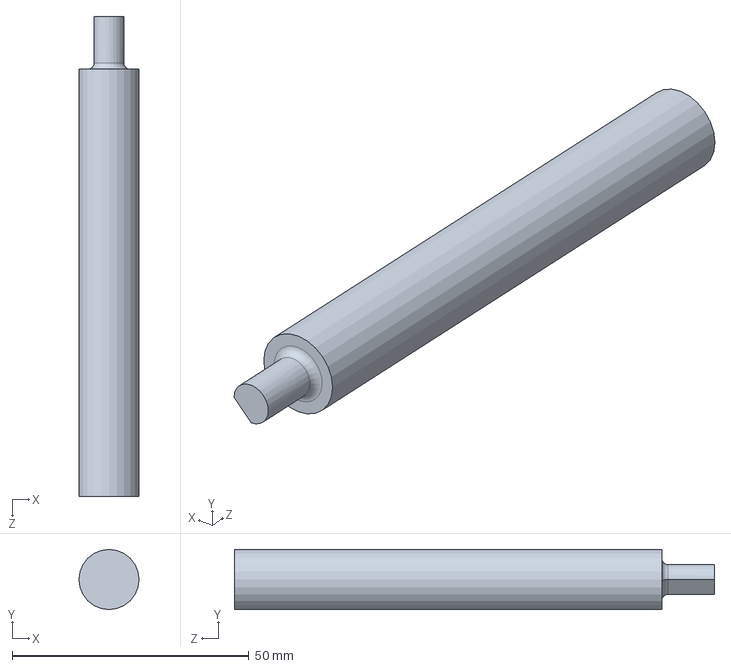
[picture p75: CAD file, 2018-11-24]
Solidworks/Machined Parts/Axle Cole.SLDPRT
12.7 x 12.7 x 101.4 mm
