its-me-ivan/Capstone/Solidworks/Machined Parts/Axle.SLDPRT

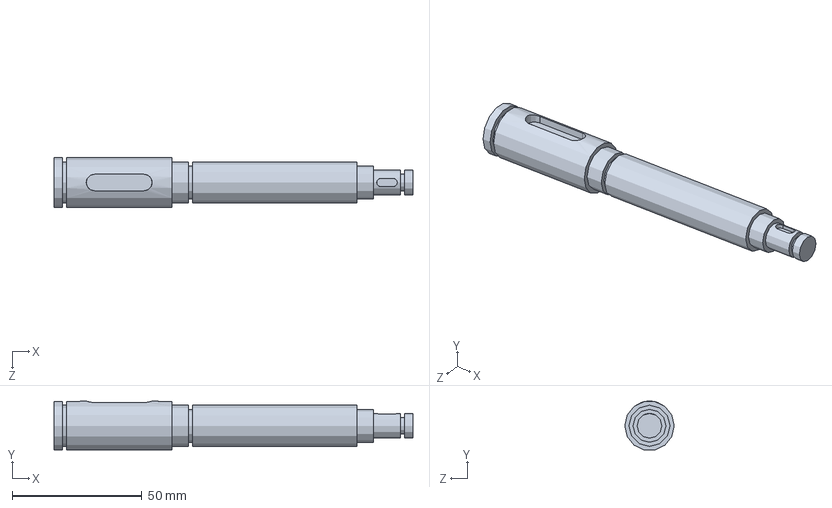
[picture p76: CAD file, 2018-11-24]
Solidworks/Machined Parts/Axle.SLDPRT
138.1 x 18.8 x 19.1 mm
