its-me-ivan/Capstone/Solidworks/Machined Parts/Motor Mount.SLDPRT

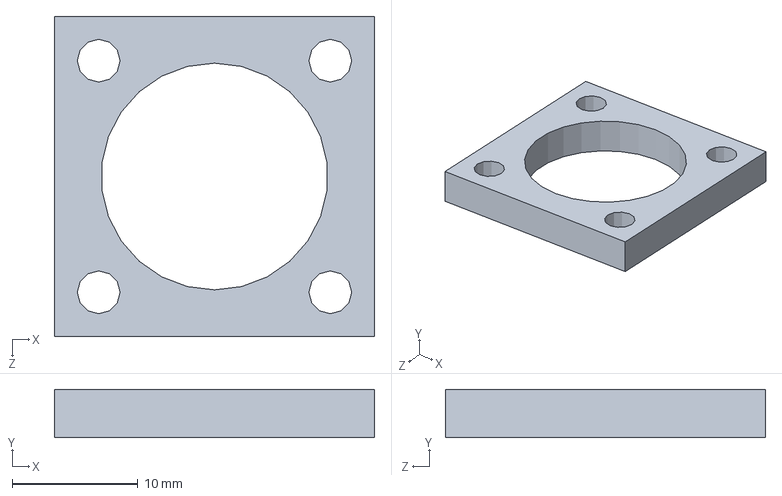
[picture p77: CAD file, 2018-11-24]
Solidworks/Machined Parts/Motor Mount.SLDPRT
25.4 x 3.81 x 25.4 mm
