its-me-ivan/Capstone/Solidworks/Machined Parts/Roller Arm.SLDPRT

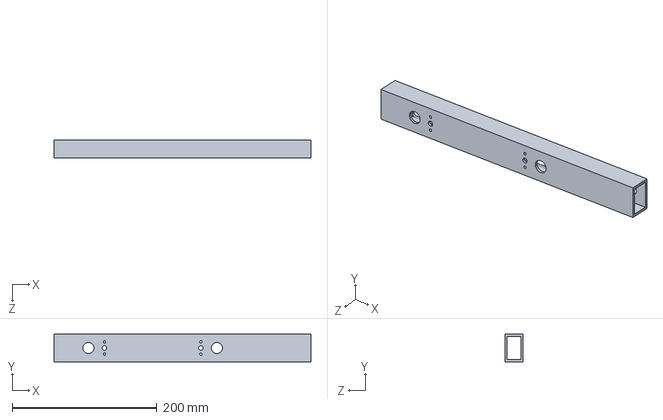
[picture p78: CAD file, 2018-11-13]
Solidworks/Machined Parts/Roller Arm.SLDPRT
355.6 x 38.1 x 25.4 mm
