its-me-ivan/Capstone/Solidworks/Machined Parts/Roller.SLDPRT

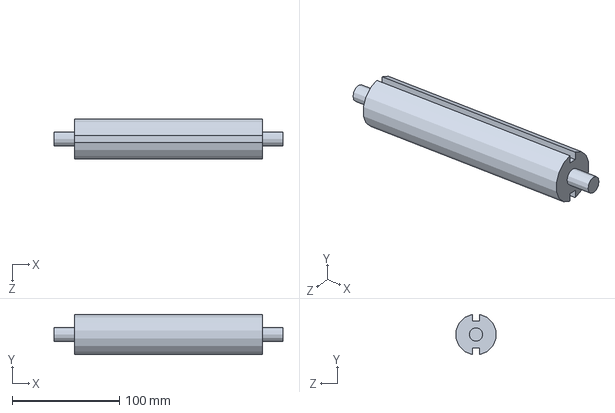
[picture p79: CAD file, 2018-11-13]
Solidworks/Machined Parts/Roller.SLDPRT
213.4 x 37.6 x 37.3 mm
