its-me-ivan/Capstone/Solidworks/Machined Parts/Frame C-Channel.SLDPRT

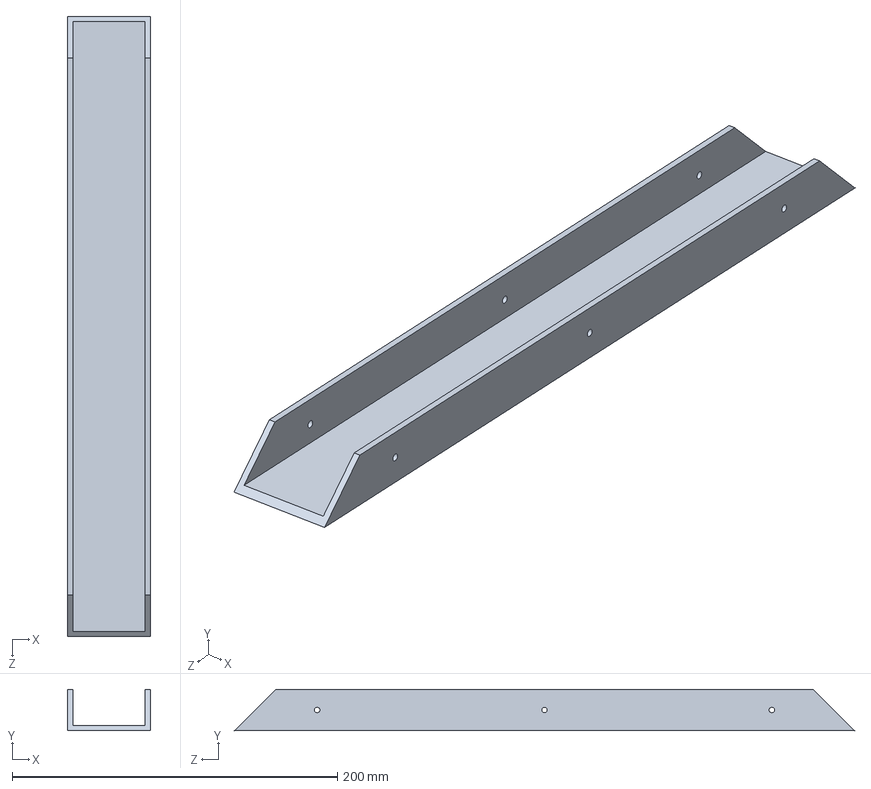
[picture p80: CAD file, 2018-11-13]
Solidworks/Machined Parts/Frame C-Channel.SLDPRT
50.8 x 25.4 x 381.0 mm
