its-me-ivan/Capstone/Solidworks/Machined Parts/Cross Brace.SLDPRT

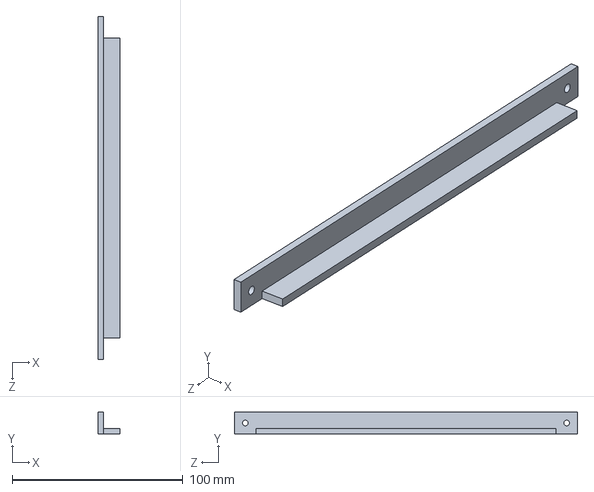
[picture p81: CAD file, 2018-11-12]
Solidworks/Machined Parts/Cross Brace.SLDPRT
12.7 x 12.7 x 200.7 mm
