its-me-ivan/Capstone/Solidworks/Machined Parts/Electronics Tray.SLDPRT

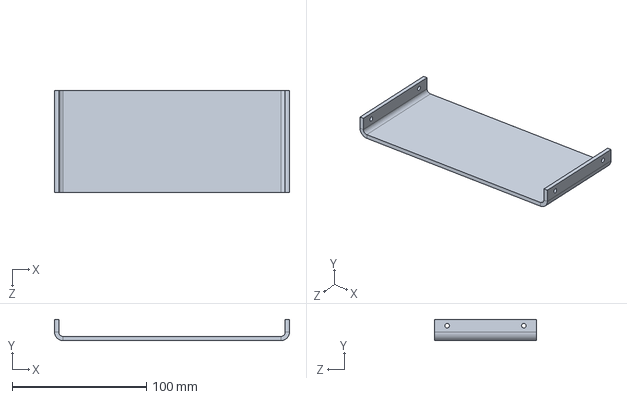
[picture p82: CAD file, 2018-11-12]
Solidworks/Machined Parts/Electronics Tray.SLDPRT
175.3 x 15.9 x 76.2 mm
