its-me-ivan/Capstone/Solidworks/Machined Parts/Key.SLDPRT

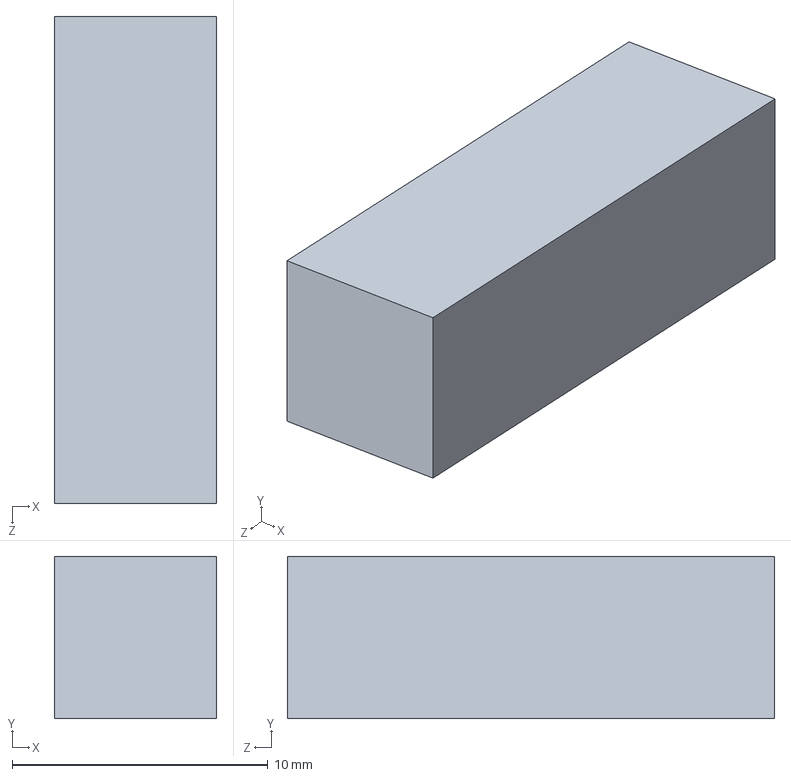
[picture p83: CAD file, 2018-11-11]
Solidworks/Machined Parts/Key.SLDPRT
6.35 x 6.35 x 19.1 mm
