its-me-ivan/Capstone/Solidworks/Machined Parts/Roller Tooth.SLDPRT

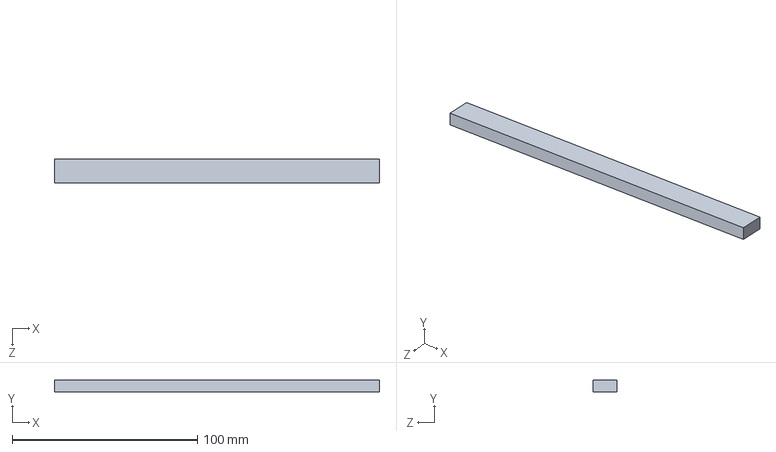
[picture p84: CAD file, 2018-11-11]
Solidworks/Machined Parts/Roller Tooth.SLDPRT
175.3 x 6.35 x 12.7 mm
