its-me-ivan/Capstone/(list of files, cad)

Other CAD files:
McMaster Parts/(Roller) 6383K213_BALL BEARING.SLDPRT
McMaster Parts/(Roller)1375K450_MXL SERIES TIMING BELT PULLEY.SLDPRT
McMaster Parts/1375K560_MXL SERIES TIMING BELT PULLEY(.5).SLDPRT
McMaster Parts/1375K560_MXL SERIES TIMING BELT PULLEY.SLDPRT
McMaster Parts/1434K600_LIGHT DTY TWO-BOLT FLANGE-MOUNTED ROLLER BRNG.SLDPRT
McMaster Parts/3060K110_2L-SECTION V-BELT PULLEY.SLDPRT
McMaster Parts/4768K110_SET SCREW COLLAR BALL BRNG.SLDPRT
McMaster Parts/5909K310_THRUST NEEDLE-ROLLER BEARING.SLDPRT
McMaster Parts/5909K440_THRUST NEEDLE-ROLLER BEARING.SLDPRT
McMaster Parts/5913K710_LOW-PROFILE MOUNTED SEALED STEEL BALL BEARING.SLDPRT
McMaster Parts/5968K710_TWO-BOLT FLANGE-MOUNT SELF-ALIGNING BALL BRNG.SLDPRT
McMaster Parts/6274K110_PLASTIC V-BELT PULLEY.SLDPRT
McMaster Parts/7887K880_MXL SERIES TIMING BELT.SLDPRT
McMaster Parts/92871A013_SS UNTHRD SPACER.SLDPRT
McMaster Parts/Axle Cole.SLDPRT
McMaster Parts/Axle2 Cole.SLDPRT
McMaster Parts/Drivin GEAR--20 DEG PRESSURE ANGLE.SLDPRT
McMaster Parts/Pinion Gear.SLDPRT
McMaster Parts/Roller Motor MXL SERIES LIGHTWEIGHT TIMING BELT PULLEY.SLDPRT
McMaster Parts/Template.SLDDRW
Solidworks/Drawings/1375K560_MXL PULLEY(.5).SLDDRW
Solidworks/Drawings/Armor Plate1.SLDDRW
Solidworks/Drawings/Armor Plate2.SLDDRW
Solidworks/Drawings/Axle Front.SLDDRW
Solidworks/Drawings/Axle Rear.SLDDRW
Solidworks/Drawings/Electrical Mounting.SLDDRW
Solidworks/Drawings/Electronic Mounting Plate Foam.SLDDRW
Solidworks/Drawings/Electronic Mounting Plate(finished).SLDDRW
Solidworks/Drawings/Electronic Mounting Plate.SLDDRW
Solidworks/Drawings/Frame Back.SLDDRW
Solidworks/Drawings/Frame Front.SLDDRW
Solidworks/Drawings/Frame Long Roller Arm.SLDDRW
Solidworks/Drawings/Frame Roller Spacer.SLDDRW
Solidworks/Drawings/Frame Short Roller Arm.SLDDRW
Solidworks/Drawings/Frame Side.SLDDRW
Solidworks/Drawings/Frame Weld.SLDDRW
Solidworks/Drawings/Gearbox Assembly.SLDDRW
Solidworks/Drawings/Gearbox.SLDDRW
Solidworks/Drawings/Main 1.SLDDRW
Solidworks/Drawings/Main 2.SLDDRW
Solidworks/Drawings/Motor Mount.SLDDRW
Solidworks/Drawings/Roller 2 Axle.SLDDRW
Solidworks/Drawings/Roller 2 Bar.SLDDRW
Solidworks/Drawings/Roller Bracket.SLDDRW
Solidworks/Drawings/Roller Brackets(mount).SLDDRW
Solidworks/Drawings/Roller Hub.SLDDRW
Solidworks/Drawings/Roller Motor MXL SERIES LIGHTWEIGHT TIMING BELT PULLEY.SLDDRW
Solidworks/Drawings/Roller Weld.SLDDRW
Solidworks/Drawings/Tube Cap.SLDDRW
Solidworks/Hardware/M3 10mm Flathead Screw.SLDPRT
