its-me-ivan/Capstone/FEA/Drop Test 2.JPG

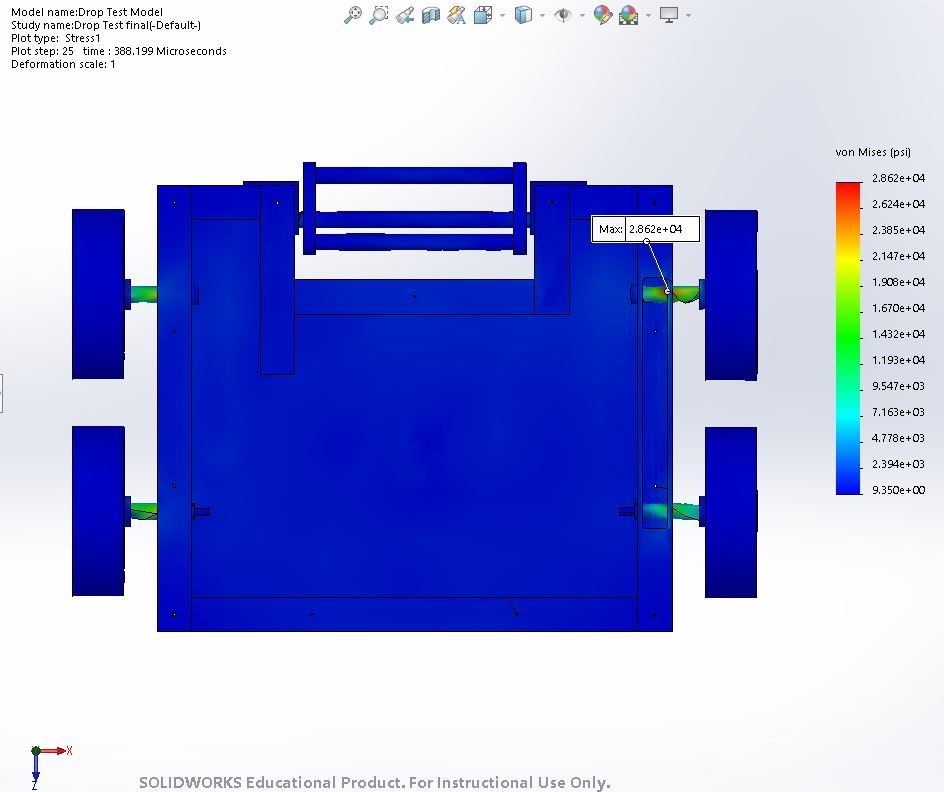
FEA/Drop Test 2.JPG
