its-me-ivan/Capstone/FEA/fea model drop test.JPG

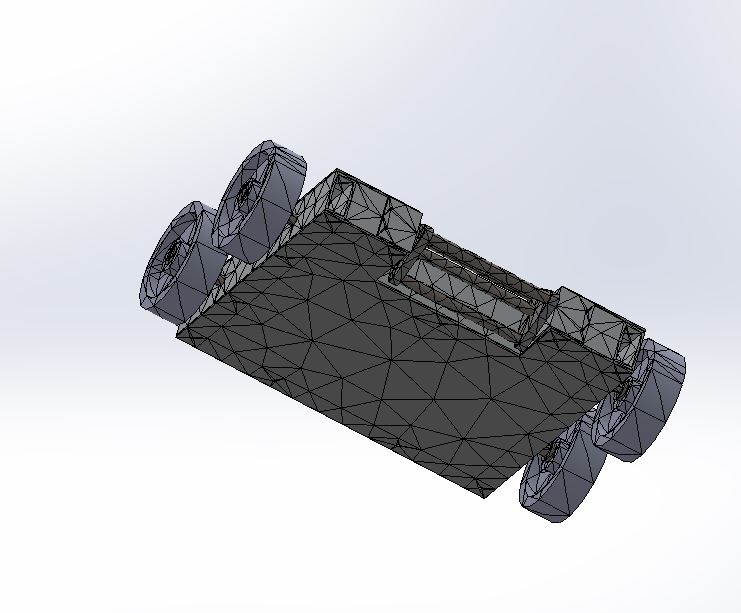
FEA/fea model drop test.JPG
