its-me-ivan/Capstone/FMEA/FMEA Ivan.xls

Failure modes and effects analysis (FMEA)
Project: | Battle Bot |  |  |  |  | Date: | 2018-11-02
FMEA Team: | Team 3 |  |  |  |  | Prepared by: | Ivan Albert, Nishagar Raventhiran, Cole Trugman
SEV = How severe is effect on the customer?
OCC = How frequent is the cause likely to occur?
DET = How probable is detection of cause?
RPN = Risk priority number in order to rank concerns; calculated as SEV x OCC x DET
Process Step Component or Subsystem | Potential failure mode | Potential failure effects | SEV | Potential causes | OCC | Current controls | DET | RPN | Actions recommended | Responsibility (target date) | Actions taken | New SEV | New OCC | New DET | New RPN
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
