its-me-ivan/Capstone/FMEA/FMEA Nishagar.xls

Failure modes and effects analysis (FMEA)
Project: | Battle Bot |  |  |  |  | Date: | 2018-11-02
FMEA Team: | Team 3 |  |  |  |  | Prepared by: | Ivan Albert, Nishagar Raventhiran, Cole Trugman
SEV = How severe is effect on the customer?
OCC = How frequent is the cause likely to occur?
DET = How probable is detection of cause?
RPN = Risk priority number in order to rank concerns; calculated as SEV x OCC x DET
Process Step Component or Subsystem | Potential failure mode | Potential failure effects | SEV | Potential causes | OCC | Current controls | DET | RPN | Actions recommended | Responsibility (target date) | Actions taken | New SEV | New OCC | New DET | New RPN
Name the process step, component or subsystem under investigation | In what ways can the process go wrong? In what ways could the component or sub-sytem fail or mal function? | What is the impact on the customer, user or environment if this failure mode happens? (Rate severity of effect in next field.) | 10 | What are potential causes for this failure mode to occur? Rate probabily for failure mode occurance in next field.) | 10 | What are the existing controls that would prevent the failure mode from occurring or would detect it's cause? (Rate the failure detectability in the next field.) | 10 | 1000 | What are the actions necessary to reduce the probability of occurrence, reduce the severity, or increase its detectability? You should provide actions on all high RPNs and on severity ratings of 9 or 10. | Who is responsible for the recommended action? What date should it be completed by? | What were the actions implemented? Include completion month/year (then recalculate resulting RPN). | 10 | 10 | 10 | 1000
Manufacturing | Improper Machining | Robot parts wouldn't be similar as designed, which may lead to oversized or undersized | 6 | Improper Tolerances | 3 | include proper GD&T in the design | 4 | 72 | Check with the group members, and other knowledgable resources to ensure the tolerances are correct |  |  |  |  |  | 0
 |  |  | 6 | Human Error | 5 | try to be focus on while processing | 10 | 300 | Be aware when machinig or processing |  |  |  |  |  | 0
 |  |  | 6 | minimal experience in the workshop | 5 | work with experienced person in the field | 3 | 90 | Work with MET student (Cole in our group) to understand the machining processes as well as other kowledgable resources |  |  |  |  |  | 0
Assembly | parts get dettached | Robot become inoperable, became a target to the opponent bot | 8 | Forgetting a screw, or washer or other small fasteners | 2 | work subasemmblies first | 8 | 128 | start working on subassmeblies and finally get together everything into the main assembly |  |  |  |  |  | 0
 | Parts misaligned | immobilized, became inoperable,KO'd in the current round | 8 | improper manufacturing | 3 | Follow proper experienced manufacturing guide | 5 | 120 | Work with MET student (Cole in our group) to understand the machining processes as well as other kowledgable resources |  |  |  |  |  | 0
wheel Sub assembly | Bent/ sheared axle | can't control as desined, become target to enemy | 5 | made of light material | 1 | Choose material wisely | 3 | 15 | have to decide the material according to its strength and cost |  |  |  |  |  | 0
 |  |  | 5 | miscalculation of load factor | 4 | Check with a knowledgeable person (may be a Professor) | 8 | 160 | Check with the group members, and other knowledgable resources to ensure the calculations are correct
 |  |  | 5 | improper placement of fastner | 5 | use engineering knowledge of shear, stress analysis | 6 | 150
 | lost/damaged wheels | immobilized, became inoperable,KO'd in the current round | 6 | Obstacles in the areana | 9 | try to avoid the obstacles in arena | 1 | 54 |  |  |  |  |  |  | 0
 |  |  | 6 | wear of tyres | 4 | purchase tyres with good traction | 4 | 96
 |  |  | 6 | Fault in design of the Body | 3 | Design it carefully and recheck with the experienced person | 6 | 108
 |  |  | 6 | tyre that is too wide for theRobot may catch on parts of the steering or suspension | 1 | select appropriate size of the tyres | 2 | 12
 | damaged bearing | break the wheel assembly, lead to immobilization of the robot and KO | 6 | low quality bearing | 6 | check for the quality when purchasing | 3 | 108 | Purchase a high quality, heat treated bearing |  |  |  |  |  | 0
 |  |  | 6 | over tightening of the bearing | 3 | Take extra care during mounting | 5 | 90 | If using tapered roller bearing, ensure that endplay should be about 0.001 to 0.005 inches |  |  |  |  |  | 0
 |  |  | 6 | overload on the bearing | 3 | select the appropriate bearing | 3 | 54 | Purchase the appropriate bearings by calculating the carrying load |  |  |  |  |  | 0
 |  |  | 6 | overheating of the bearing | 4 | select the appropriate bearing for the required load | 5 | 120 | Purchase the appropriate bearings by calculating the carrying load |  |  |  |  |  | 0
Competition Rules | over sized | Getting eliminated from the competition | 9 | improper tolerancing of design and manufacturing | 3 | Maintain track of the design and tolerances throught the process | 3 | 81 | Planning and outlinning the process beforehand will reduce the failure |  |  |  |  |  | 0
 | overweight |  | 9 | Weight of the roller and wedge add on extra weight to the robot | 7 | try to use light weight as well as strong metal for weapon | 4 | 252 | Planning and outlinning the process beforehand will reduce the failure |  |  |  |  |  | 0
 | having sharp edges or weapons |  | 9 | create a cool design without knowing it has a sharp edges or weapons | 2 | Design the robot carefully | 3 | 54 | Planning and outlinning the process beforehand will reduce the failure |  |  |  |  |  | 0
 | excedding budgets |  | 9 | spending over the budget for extra strength or weapons system | 1 | keep track of purchases | 2 | 18 | Cooperate Bill of materials in the manufacturing plan, maintain track of purchases |  |  |  |  |  | 0
 |  |  |  |  |  |  |  | 0 |  |  |  |  |  |  | 0
 |  |  |  |  |  |  |  | 0 |  |  |  |  |  |  | 0
