its-me-ivan/Capstone/Solidworks/Drawings/Electronic Mounting Plate Foam.PDF

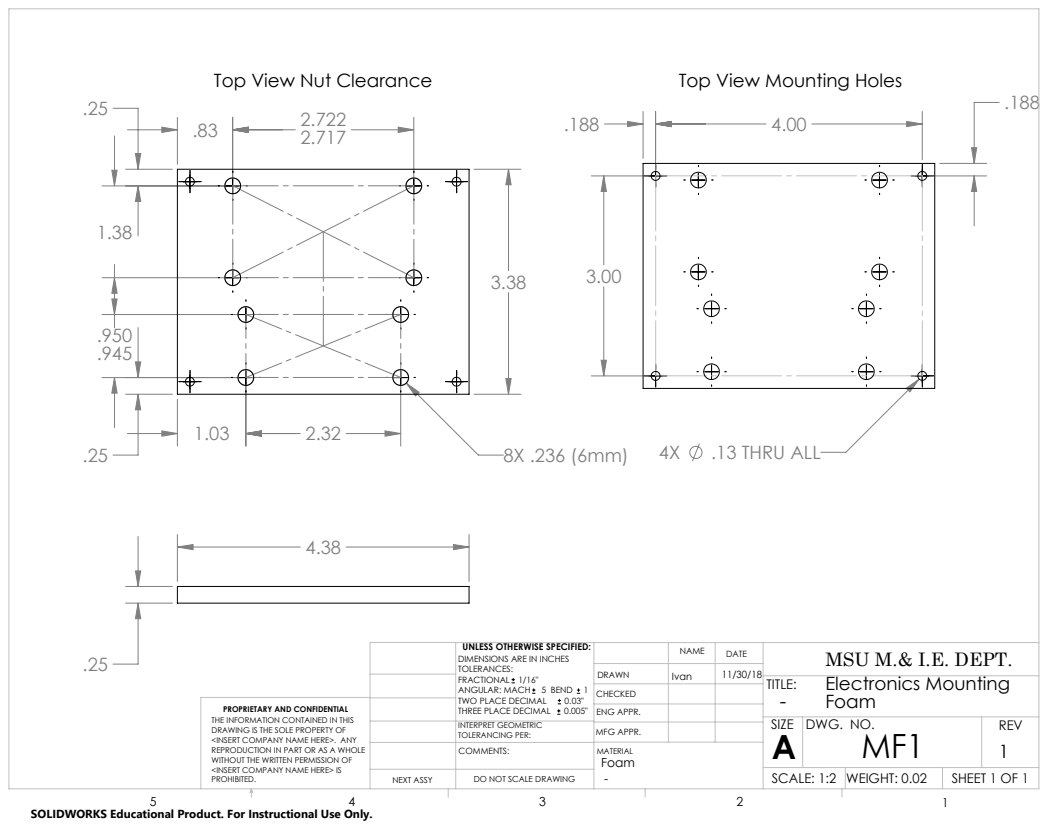
[picture p87: page 1]
.13 THRU ALL; Top View Nut Clearance; Top View Mounting Holes; SHEET 1 OF 1; SCALE: 1:2 WEIGHT: 0.02; DWG. NO.; REV; MFG APPR.; ENG APPR.; TWO PLACE DECIMAL; NEXT ASSY; MSU M.& I.E. DEPT. Electronics Mounting

UNLESS OTHERWISE SPECIFIED:
DIMENSIONS ARE IN INCHES
TOLERANCES:
FRACTIONAL 1/16"
ANGULAR: MACH 5 BEND 1
THREE PLACE DECIMAL 0.005"
INTERPRET GEOMETRIC
TOLERANCING PER:
COMMENTS:

PROPRIETARY AND CONFIDENTIAL
THE INFORMATION CONTAINED IN THIS
DRAWING IS THE SOLE PROPERTY OF
<INSERT COMPANY NAME HERE>. ANY
REPRODUCTION IN PART OR AS A WHOLE
WITHOUT THE WRITTEN PERMISSION OF
<INSERT COMPANY NAME HERE> IS
PROHIBITED.

DO NOT SCALE DRAWING

SOLIDWORKS Educational Product. For Instructional Use Only.
