its-me-ivan/Capstone/Solidworks/Drawings/Gearbox Assembly.PDF

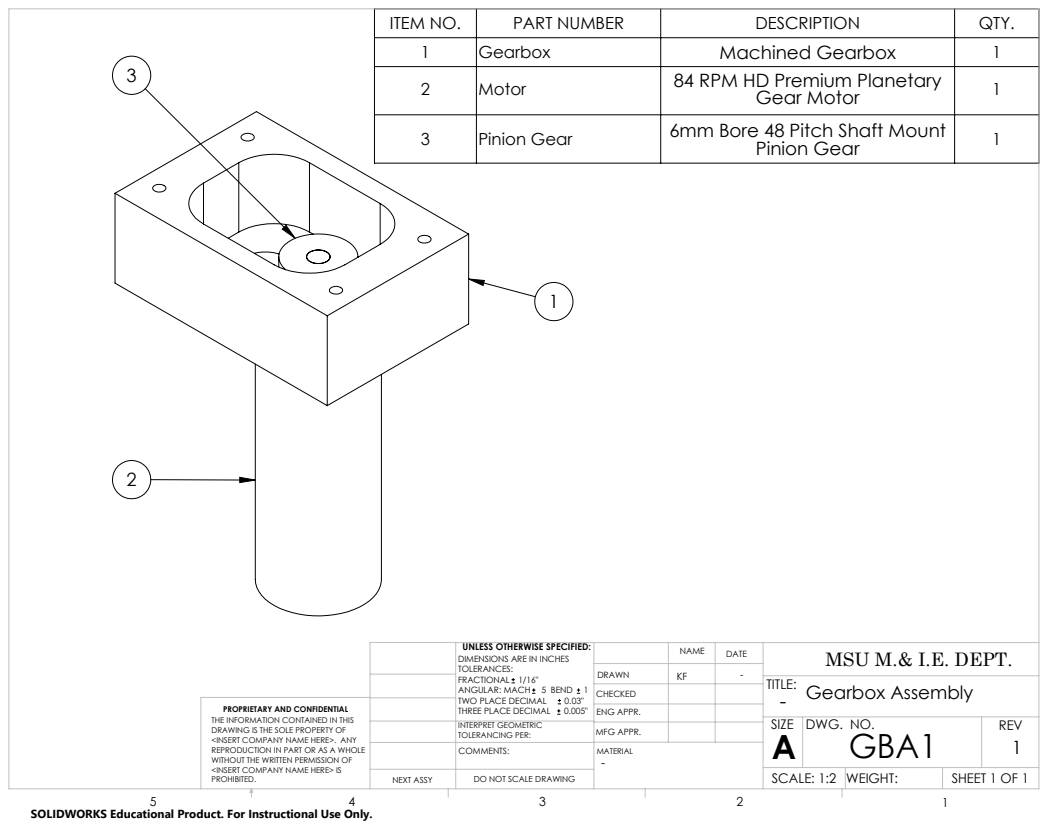
[picture p88: page 1]
SHEET 1 OF 1; SCALE: 1:2 WEIGHT:; DWG. NO.; REV; MFG APPR.; ENG APPR.; TWO PLACE DECIMAL; NEXT ASSY; MSU M.& I.E. DEPT. Gearbox Assembly

ITEM NO. | PART NUMBER | DESCRIPTION | QTY.
1 | Gearbox | Machined Gearbox | 1
2 | Motor | 84 RPM HD Premium Planetary Gear Motor | 1

3 | Pinion Gear | 6mm Bore 48 Pitch Shaft Mount Pinion Gear | 1

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

DO NOT SCALE DRAWING

SOLIDWORKS Educational Product. For Instructional Use Only.
