its-me-ivan/Capstone/Solidworks/Drawings/Roller Hub.PDF

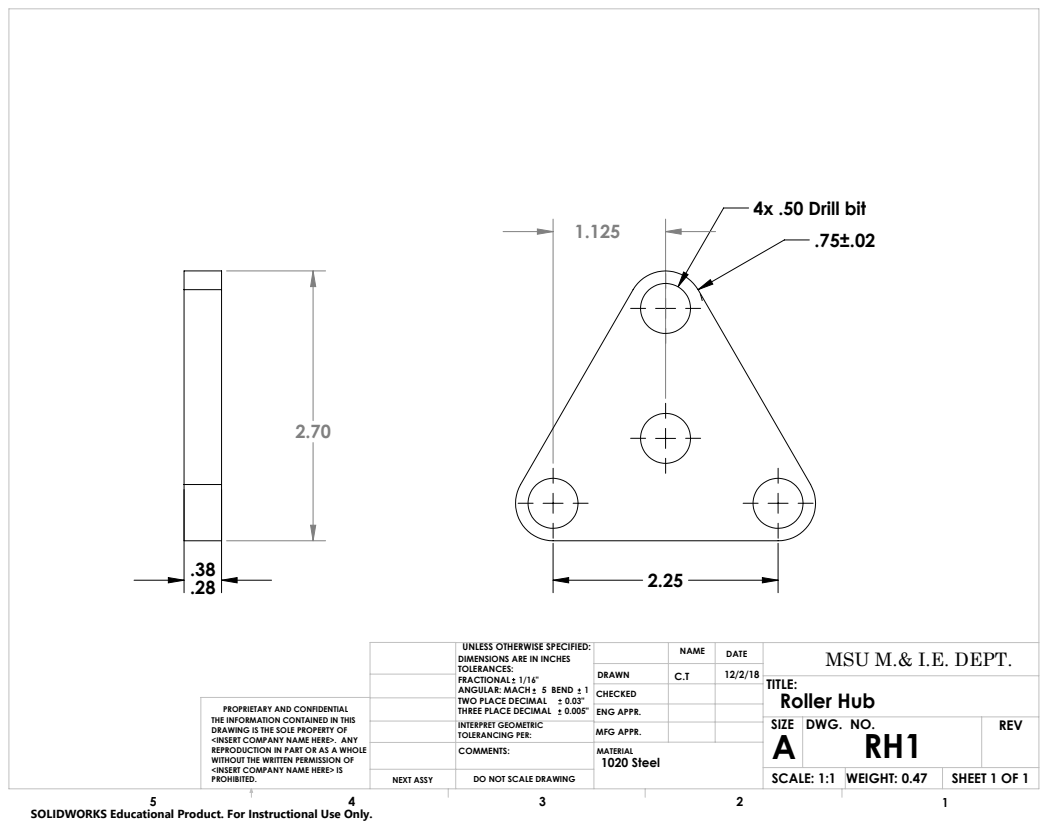
[picture p89: page 1]
4x .50 Drill bit; Roller Hub; SHEET 1 OF 1; SCALE: 1:1 WEIGHT: 0.47; DWG. NO.; REV; MFG APPR.; ENG APPR.; 1020 Steel; TWO PLACE DECIMAL; NEXT ASSY; MSU M.& I.E. DEPT.

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

DO NOT SCALE DRAWING

SOLIDWORKS Educational Product. For Instructional Use Only.
