its-me-ivan/Capstone/Solidworks/Drawings/1375K560_MXL PULLEY(.PDF

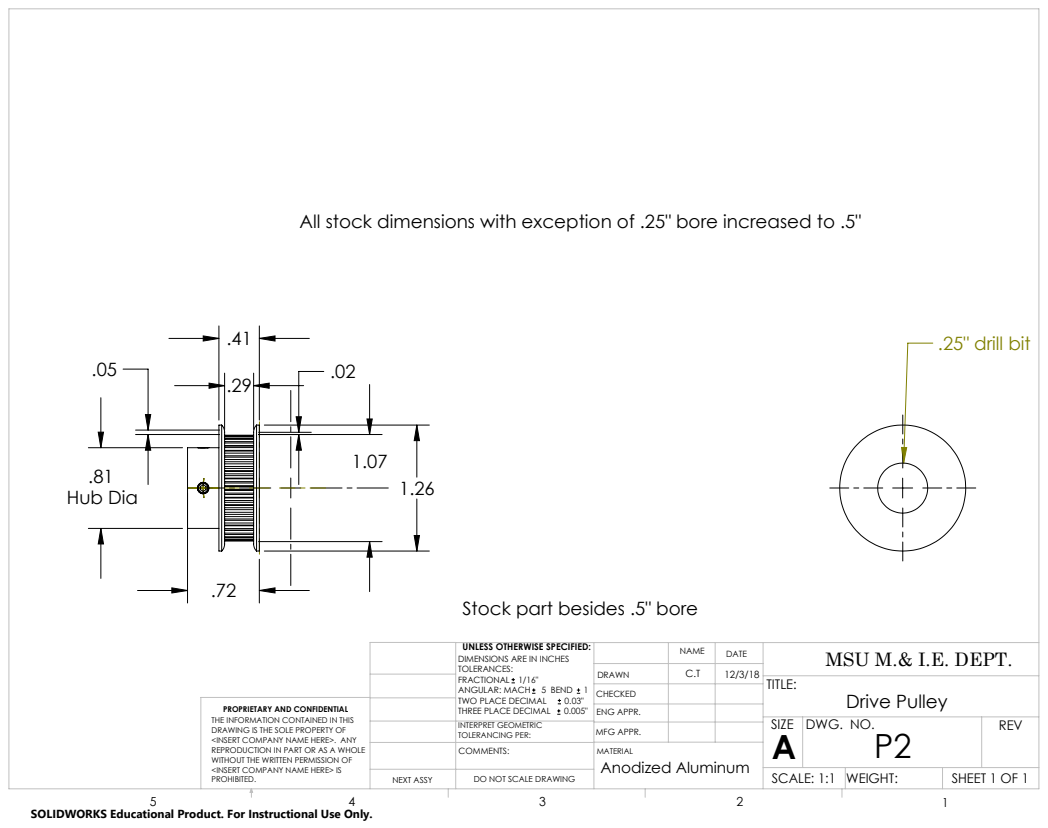
[picture p90: page 1]
Hub Dia; .25" drill bit; SHEET 1 OF 1; SCALE: 1:1 WEIGHT:; DWG. NO.; REV; MFG APPR.; ENG APPR.; TWO PLACE DECIMAL; NEXT ASSY; MSU M.& I.E. DEPT.; Drive Pulley; Anodized Aluminum

All stock dimensions with exception of .25" bore increased to .5"

Stock part besides .5" bore

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

DO NOT SCALE DRAWING

SOLIDWORKS Educational Product. For Instructional Use Only.
