its-me-ivan/Capstone/Solidworks/Drawings/Electrical Mounting.PDF

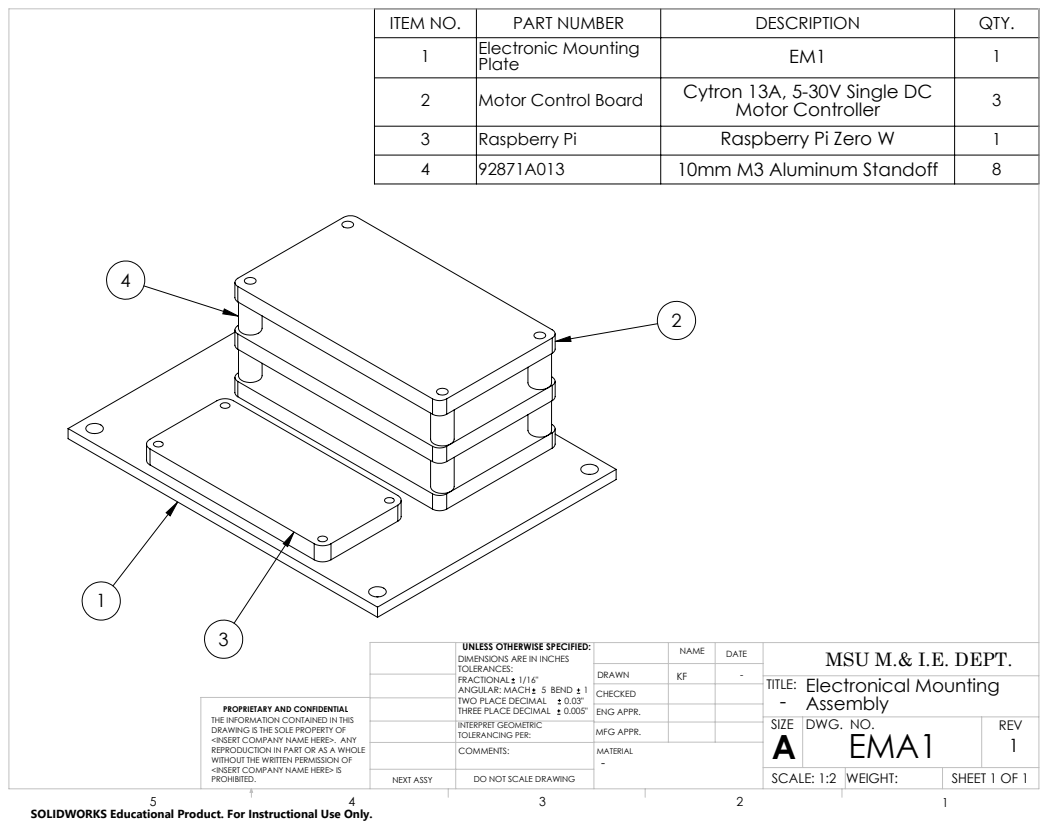
[picture p91: page 1]
Electronical Mounting; SHEET 1 OF 1; SCALE: 1:2 WEIGHT:; DWG. NO.; REV; MFG APPR.; ENG APPR.; TWO PLACE DECIMAL; NEXT ASSY; MSU M.& I.E. DEPT.

ITEM NO. | PART NUMBER | DESCRIPTION | QTY.
1 | Electronic Mounting Plate | EM1 | 1
2 | Motor Control Board | Cytron 13A, 5-30V Single DC Motor Controller | 3
3 | Raspberry Pi | Raspberry Pi Zero W | 1
4 | 92871A013 | 10mm M3 Aluminum Standoff | 8

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

DO NOT SCALE DRAWING

SOLIDWORKS Educational Product. For Instructional Use Only.
