its-me-ivan/Capstone/Solidworks/Drawings/Frame Long Roller Arm.PDF

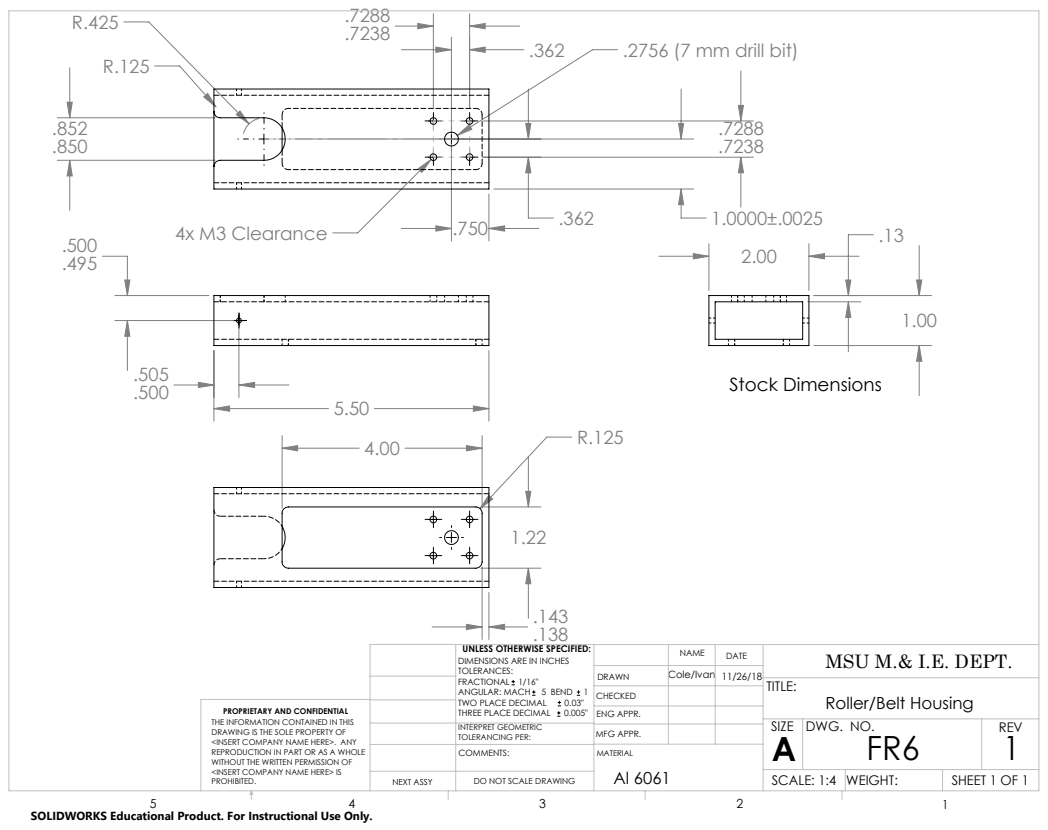
[picture p92: page 1]
4x M3 Clearance; Stock Dimensions; SHEET 1 OF 1; Cole/Ivan 11/26/18; SCALE: 1:4 WEIGHT:; DWG. NO.; REV; MFG APPR.; ENG APPR.; TWO PLACE DECIMAL; NEXT ASSY; MSU M.& I.E. DEPT.

.2756 (7 mm drill bit)

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

TITLE:
Roller/Belt Housing
SIZE

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

DO NOT SCALE DRAWING

SOLIDWORKS Educational Product. For Instructional Use Only.
