its-me-ivan/Capstone/(commit log)

2018-09-19 Gantt Chart
    [Gantt Chart.xlsx]
2018-09-26 Background Update (Cole)
    [Gantt Chart.xlsx]
2018-10-08 Initial Section 5
    [Design Alternatives Tables.xlsx]
2018-10-09 design specs (cole)
    [Design Alternatives Tables.xlsx, Gantt Chart.xlsx]
2018-10-10 Specs edit and Project management
    [Gantt Chart.xlsx]
2018-10-10 Updated alternatives
    [Design Alternatives Tables.xlsx]
2018-10-11 Finished Design Alternatives
    [Design Alternatives Tables.xlsx]
2018-10-18 Added individuak rolls
    [Gantt Chart.xlsx]
2018-10-21 Added tables for slides
    [Design Alternatives Tables PDR.xlsx]
2018-10-21 Added Powerpoint
2018-11-01 FMEA worksheet has been added
    [FMEA Worksheet.xls]
2018-11-01 Created FMEA folder, did electrical FMEA
    [FMEA Ivan.xls, FMEA Worksheet.xls]
2018-11-02 I uploaded my FMEA part. let me know if you have anything on it
    [FMEA Ivan.xls, FMEA Nishagar.xls, FMEA Worksheet.xls]
2018-11-02 Update Ivan's FMEA
    [FMEA Ivan.xls]
2018-11-02 Started combining FMEA
    [FMEA.xls]
2018-11-02 Update FMEA/FMEA Cole - Copy.xls
    [FMEA Cole - Copy.xls]
2018-11-02 Final FMEA sheet and Group Action Plan
    [FMEA.xls]
2018-11-09 Updated project management
    [Gantt Chart.xlsx]
2018-11-11 Solidworks Model Started
    [25mmMotorMount.SLDPRT, Armor Plate.SLDPRT, Frame C-Channel.SLDPRT, Frame.SLDASM, Motor.SLDPRT, Raspberry Pi.SLDPRT, Rear Bumper.SLDPRT, Robot.SLDASM]
2018-11-11 Solidworks Update
    [Axle.SLDPRT, Electronics Tray.SLDPRT, Frame C-Channel.SLDPRT, Frame.SLDASM, Key.SLDPRT, M3 10mm Flathead Screw.SLDPRT, Motor Mount.SLDPRT, Motor.SLDPRT]
2018-11-12 Solidworks Update
    Added motors, braces to protect electronics, some screw holes
    [Armor Plate.SLDPRT, Cross Brace.SLDPRT, Electronics Tray.SLDPRT, Frame C-Channel.SLDPRT, Frame.SLDASM, Raspberry Pi.SLDPRT, Robot.SLDASM, Roller Arm.SLDPRT]
2018-11-13 Aluminum Frame
    Steel was too heavy
    [Frame C-Channel.SLDPRT, Frame.SLDASM, Robot.SLDASM, Roller Arm.SLDPRT, Roller.SLDASM, Roller.SLDPRT]
2018-11-20 added roller 2
    [Roller 2 Bar.SLDPRT, Roller 2.SLDASM, Roller Bracket.SLDPRT]
2018-11-21 Frame Rework pt1
    [Box Frame.SLDPRT, Frame 2.SLDASM]
2018-11-22 Frame 2 update
    [Armor Plate.SLDPRT, Box Frame.SLDPRT, Frame 2.SLDASM, Roller Brackets.SLDPRT, Tube Cap.SLDPRT]
2018-11-22 mcmaster parts and assembly
    [1434K600_LIGHT DTY TWO-BOLT FLANGE-MOUNTED ROLLER BRNG.SLDPRT, 3060K110_2L-SECTION V-BELT PULLEY.SLDPRT, 4768K110_SET SCREW COLLAR BALL BRNG.SLDPRT, 5909K310_THRUST NEEDLE-ROLLER BEARING.SLDPRT, 5909K440_THRUST NEEDLE-ROLLER BEARING.SLDPRT, 5913K710_LOW-PROFILE MOUNTED SEALED STEEL BALL BEARING.SLDPRT, 5968K710_TWO-BOLT FLANGE-MOUNT SELF-ALIGNING BALL BRNG.SLDPRT, 6274K110_PLASTIC V-BELT PULLEY.S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]
2018-11-22 Armor Plate Fix
    [Armor Plate.SLDPRT]
2018-11-23 Frame fix
    [Box Frame.SLDPRT, Frame 2.SLDASM, Tube Cap.SLDPRT]
2018-11-23 New top level model started
    screw holes for armor redone
    [Armor Plate.SLDPRT, Box Frame.SLDPRT, Frame 2.SLDASM, Robot 2.SLDASM, Roller Brackets.SLDPRT]
2018-11-23 Gearbox Mockup
    [Gearbox.SLDPRT]
2018-11-23 Solid Model Update
    [Armor Plate.SLDPRT, Box Frame.SLDPRT, Electrical Mounting.SLDASM, Electronic Mounting Plate Foam.SLDPRT, Electronic Mounting Plate.SLDPRT, Frame 2.SLDASM, Gearbox.SLDASM, Gearbox.SLDPRT]
2018-11-24 Gear Box
    Added Gearing
    [5968K710_TWO-BOLT FLANGE-MOUNT SELF-ALIGNING BALL BRNG.SLDPRT, Armor Plate.SLDPRT, Axle.SLDPRT, Box Frame.SLDPRT, Drivin GEAR--20 DEG PRESSURE ANGLE.SLDPRT, Electrical Mounting.SLDASM, Electronic Mounting Plate Foam.SLDPRT, Electronic Mounting Plate.SLDPRT]
2018-11-24 Added some pulley
    [1375K560_MXL SERIES TIMING BELT PULLEY.SLDPRT, Axle Cole.SLDPRT, Axle2 Cole.SLDPRT, Box Frame.SLDPRT]
2018-11-24 4th wheel added
    [1375K560_MXL SERIES TIMING BELT PULLEY.SLDPRT, Axle Cole.SLDPRT, Axle2 Cole.SLDPRT, Box Frame.SLDPRT, Frame 2.SLDASM, Robot 2.SLDASM]
2018-11-24 Added electronics
    [92871A013_SS UNTHRD SPACER.SLDPRT, Battery Pack.SLDPRT, Box Frame.SLDPRT, Electrical Mounting.SLDASM, Electronic Mounting Plate Foam.SLDPRT, Electronic Mounting Plate.SLDPRT, Frame 2.SLDASM, Gearbox.SLDASM]
2018-11-26 Robot 2 Update
    [1375K560_MXL SERIES TIMING BELT PULLEY(.5).SLDPRT, 1375K560_MXL SERIES TIMING BELT PULLEY.SLDPRT, 25mmMotorMount.SLDPRT, 5913K710_LOW-PROFILE MOUNTED SEALED STEEL BALL BEARING.SLDPRT, 7887K880_MXL SERIES TIMING BELT.SLDPRT, Armor Plate.SLDPRT, Axle Cole.SLDPRT, Axle2 Cole.SLDPRT]
2018-11-26 Tap Holes and Roller Mount redo
    [Box Frame.SLDPRT, Frame 2.SLDASM, Robot 2.SLDASM, Roller 2 Bar.SLDPRT, Roller 2.SLDASM, Roller Brackets.SLDPRT]
2018-11-26 Frame Drawings
    [Box Frame.SLDPRT, Frame 2.SLDASM, Frame Back.SLDDRW, Frame Front.SLDDRW, Frame Long Roller Arm.SLDDRW, Frame Roller Spacer.SLDDRW, Frame Short Roller Arm.SLDDRW, Frame Side.SLDDRW]
2018-11-26 Fixed slot
    [Box Frame.SLDPRT]
2018-11-27 Toleranced Frame
    [Armor Plate1.SLDDRW, Axle Front.SLDDRW, Axle2 Cole.SLDPRT, Box Frame.SLDPRT, Frame 2.SLDASM, Frame Back.SLDDRW, Frame Front.SLDDRW, Frame Long Roller Arm.SLDDRW]
2018-11-28 Create Budget Plan.xlsx
    [Budget Plan.xlsx]
2018-11-28 Create Budget Plan (version 1).xlsx
    [Budget Plan (version 1).xlsx]
2018-11-29 Update Budget Plan (version 1).xlsx
    [Budget Plan (version 1).xlsx]
2018-11-30 Ivan OpSheet
    [Armor Plate1.SLDDRW, Armor Plate2.SLDDRW, Electronic Mounting Plate.SLDDRW, Frame 2.SLDASM, OpSheet (Ivan).xlsx, Robot 2.SLDASM]
2018-11-30 Opsheet
    Opshhet Cole
    [1375K560_MXL PULLEY(.5).SLDDRW, Armor Plate1.SLDDRW, Axle Front.SLDDRW, Axle Rear.SLDDRW, Box Frame.SLDPRT, Electronic Mounting Plate.SLDDRW, Frame Back.SLDDRW, Frame Front.SLDDRW]
2018-11-30 Added roller bracket
    [OpSheet (Ivan).xlsx]
2018-12-04 View Stuff
    [Frame 2.SLDASM, Robot 2.SLDASM]
2018-12-05 Roller Pulley
    [Roller Motor MXL SERIES LIGHTWEIGHT TIMING BELT PULLEY.SLDDRW, Roller Motor MXL SERIES LIGHTWEIGHT TIMING BELT PULLEY.SLDPRT]
2018-12-05 Update Robot 2.SLDASM
    [Robot 2.SLDASM]
2018-12-05 Main Drawings
    [Armor Plate.SLDPRT, Electrical Mounting.SLDDRW, Frame 2.SLDASM, Gearbox Assembly.SLDDRW, Gearbox.SLDASM, Main 1.SLDDRW, Main 2.SLDDRW, Robot 2.SLDASM]
2018-12-05 Some more Drawings
    [Electronic Mounting Plate Foam.SLDDRW, Frame 2.SLDASM, Motor Mount.SLDDRW, Robot 2.SLDASM]
2018-12-05 Update Axle2 Cole.SLDPRT
    [Axle2 Cole.SLDPRT]
2018-12-06 Drawing Package
    [(Roller)1375K450_MXL SERIES TIMING BELT PULLEY.SLDPRT, 1375K560_MXL PULLEY(.5).SLDDRW, 1375K560_MXL SERIES TIMING BELT PULLEY(.5).SLDPRT, 1375K560_MXL SERIES TIMING BELT PULLEY.SLDPRT, Armor Plate1.SLDDRW, Armor Plate2.SLDDRW, Axle Front.SLDDRW, Axle Rear.SLDDRW]
2018-12-07 Weld Drawings
    [Frame 2.SLDASM, Frame Weld.SLDDRW, Main 1.SLDDRW, Robot 2.SLDASM, Roller Weld.SLDDRW]
2018-12-07 Update Design Alternatives Tables.xlsx
    [Design Alternatives Tables.xlsx]
2018-12-07 Drawing PDFs
    [Electronic Mounting Plate Foam.SLDDRW, Frame Back.SLDDRW, Frame Side.SLDDRW, Frame Weld.SLDDRW]
2018-12-07 Electronics Mounting Plate and Roller Bracket Drawings
    [Electronic Mounting Plate(finished).SLDDRW, Electronic Mounting Plate.SLDPRT, Roller Bracket.SLDDRW, Roller Brackets.SLDPRT]
2018-12-07 Gantt update
    [Gantt Chart.xlsx]
2018-12-07 Update Gantt Chart.xlsx
    [Gantt Chart.xlsx]
2018-12-07 Man. Plan
    [Armor Plate1.SLDDRW, Armor Plate2.SLDDRW, Axle Front.SLDDRW, OpSheet(Cole).xlsx, Roller Brackets(mount).SLDDRW]
2018-12-09 Fixed Drawings
    [Frame Weld.SLDDRW, Roller Weld.SLDDRW]
2018-12-09 Appendix B
    [Armor Plate1.SLDDRW, Armor Plate2.SLDDRW, Gearbox.SLDASM, OpSheet(Cole).xlsx, Robot 2.SLDASM, Roller 2 Axle.SLDDRW, Roller 2.SLDASM, Roller Hub.SLDDRW]
2018-12-10 Create Roller bracket.pdf
2018-12-10 Report Update
    [1375K560_MXL SERIES TIMING BELT PULLEY(.5).SLDPRT, Design Alternatives Tables.xlsx, Roller 2 Bar.SLDPRT]
2018-12-10 Fixed Gantt Cahrt
    [Gantt Chart.xlsx, Part List.xlsx]
2018-12-10 Added appendix D, general edditing
    [Part List.xlsx]
2019-01-17 Roller Bracket Update
    [Order Budget.xlsx, Robot 2.SLDASM, Roller 2 Bar.SLDPRT, Roller 2.SLDASM, Roller Attachment 2.SLDPRT, Roller Brackets.SLDPRT]
2019-01-22 Chasis Adjusted to accomidate new brackets
    [Armor Plate.SLDPRT, Box Frame.SLDPRT, Frame 2.SLDASM, Robot 2.SLDASM]
2019-01-26 shortened body
    length of body reduced by 1 inch to reduce weight with steel armor.
    [Armor Plate.SLDPRT, Box Frame.SLDPRT, Frame 2.SLDASM, Gantt Chart.xlsx, Robot 2.SLDASM, Roller 2.SLDASM, Roller Bracket.SLDPRT]
2019-02-05 Changed threading
    [Armor Plate.SLDPRT, Box Frame.SLDPRT, Frame 2.SLDASM, Gearbox.SLDASM, Gearbox.SLDPRT, Robot 2.SLDASM, Roller Attachment 2.SLDPRT]
2019-02-06 Changed to polycarbonate armor
    [Armor Plate.SLDPRT, Axle2 Cole.SLDPRT, Robot 2.SLDASM, Wheel Hub.SLDPRT]
2019-02-06 Update Order Budget.xlsx
    [Order Budget.xlsx]
2019-02-06 Fixed Plates
    [Armor Plate.SLDPRT, Axle Cole.SLDPRT, Robot 2.SLDASM]
